steveyme19/barbell-tracker/hardware/enclosure/stl/puck_a.stl

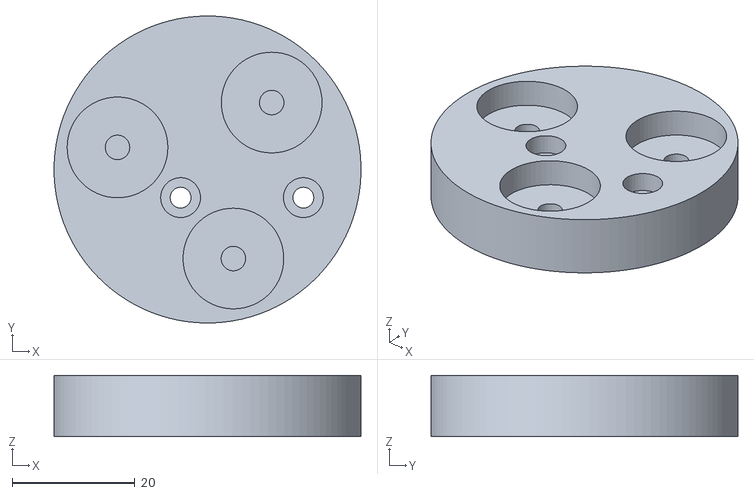
[picture p3: CAD file, 2026-10-30]
hardware/enclosure/stl/puck_a.stl
50.0 x 50.0 x 10.0
