steveyme19/barbell-tracker/hardware/enclosure/stl/pod_lid.stl

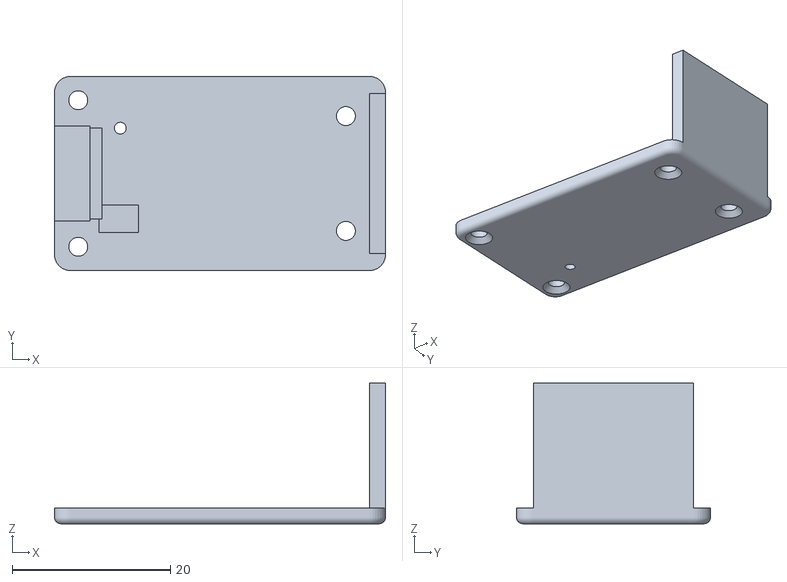
[picture p4: CAD file, 2026-10-30]
hardware/enclosure/stl/pod_lid.stl
41.8 x 24.5 x 17.8
