steveyme19/barbell-tracker/hardware/enclosure/stl/pod_case.stl

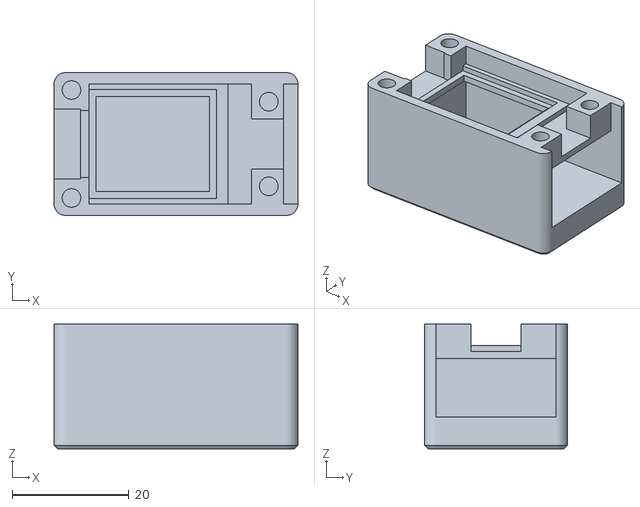
[picture p5: CAD file, 2026-10-30]
hardware/enclosure/stl/pod_case.stl
41.8 x 24.5 x 21.4
