steveyme19/barbell-tracker/analysis/make_fake_motion.py

"""
Fake IMU recordings with known truth for orientation and bar path (roadmap 0.3, algorithm.md
sections 2, 11, 12; checked by orientation.py --selftest).

    python make_fake_motion.py            # every scenario -> data/fake_motion_<name>.csv (+ _truth.csv)
    python make_fake_motion.py roll       # just one

Exact physics, then sensor noise: the device moves along min-jerk translations and turns about
one body axis at a time (which makes the gyro's body rate exact: theta_dot times that axis). The
accelerometer reads the specific force in the sensor frame, R^T (a + g up); the gyro reads the body
rate plus a constant bias and white noise. The mount is skewed on purpose (rolled 25 degrees about
the bar), so no sensor axis points up. World frame: x forward, y along the bar, z up. Sensor x
lies along the bar (a mount that forces it, algorithm.md section 11); every scenario starts with
the 2 s roll gesture anyway, so the bar axis can also be found from the gyro.

Scenarios (the roadmap 0.3 tests, plus a bench-style J-curve):
    flat      three 40 cm lifts, the device's attitude fixed
    tilt      the same lifts, the bar tilting 25 degrees (one end up) and back during each
    roll      the same lifts, the device rolling a full turn around the bar during each (sleeve spin)
    slide     slid 50 cm forward along a table and back, flat
    diagonal  lifted 30 cm up and 20 cm forward onto a table, and back down
    jcurve    three bench reps: 40 cm up with a 10 cm forward sweep, and back
    tiltroll  the bar tilted 20 degrees, two lifts spinning a full turn about the tilted bar, leveled
    early     the roll gesture before the first still (ending 10 degrees off where it began), then lifts

Gym scenarios (GYM, not in SCENARIOS: orientation.py --selftest runs every SCENARIOS entry against
the mount, noise and roll gesture above, and a loaded bar has none of those):
    squat_tng a whole touch-and-go squat set as the pod on Adapter A sees it (the 10-31 gym day):
              racked, unrack, walkout, 6 reps (one with a 0.85 s lockout pause), walk-in, a clanging
              rerack, racked. Writes data/fake_motion_squat_tng.csv, its per-sample _truth.csv and
              _truth.json with every rep's concentric start/end, ROM and MCV from the exact path
    deadlift_pins  10 dead-stop deadlifts from the pins (a rack pull), Adapter A: between reps the bar
              sits on the pins with hands on it (the 10-31 floor rests' 20 Hz: no still from the grip to
              the let-go) and every set-down leaves the sleeve spinning on its bearing, 2.5 turns in all.
              The gyro reads 1.5% fast, so without the quasi-still pulls (or with BAR_AXIS wrong) the
              attitude drifts 10 deg and the set falls apart; with them it holds. Same three files
    deadlift_creep  6 deadlifts from the floor, Adapter A, the accel calibrated: four leave the floor
              creeping (1 to 2.6 cm at 3.5 to 5.5 cm/s on average, |a| under 0.5: the 0.37 s flat test
              runs on into the pull), two with a 6 cm hitch (0.3 s at 2 to 3 cm/s, then the pull: 10-31's
              rep 1). Rep 1 comes out of a 5.5 s quiet setup (a true still: the window starts at the pull),
              the others after 1.5 s on the floor with hands on the bar and the set-down ringing. Same three files
"""

import sys
from pathlib import Path

import numpy as np

FS = 208.0                       # Hz, the pod's IMU rate (INFO odr)
G = 9.80665                      # m/s^2
ACC_NOISE = 0.012                # m/s^2, white (the pod's rest wiggle is ~0.01)
GYRO_NOISE = 0.07                # deg/s, white
GYRO_BIAS = np.array([0.4, -0.3, 0.2])   # deg/s, constant: orientation.py takes it from the stills
MOUNT_ROLL = 25.0                # deg: the device sits rolled about the bar, no axis points up
HEADER = ('"Time (s)","Acceleration x (m/s^2)","Acceleration y (m/s^2)","Acceleration z (m/s^2)",'
          '"Absolute acceleration (m/s^2)","Gyro x (deg/s)","Gyro y (deg/s)","Gyro z (deg/s)"')
OUT = Path(__file__).parent / "data"


def min_jerk(tau):
    """s, ds/dtau, d2s/dtau2 of the min-jerk profile 10t^3 - 15t^4 + 6t^5 on [0, 1]."""
    return (10 * tau**3 - 15 * tau**4 + 6 * tau**5, 30 * tau**2 - 60 * tau**3 + 30 * tau**4,
            60 * tau - 180 * tau**2 + 120 * tau**3)


def rot(axis, angle):
    """Rotation matrix about a unit axis (Rodrigues)."""
    a = np.asarray(axis, float) / np.linalg.norm(axis)
    k = np.array([[0, -a[2], a[1]], [a[2], 0, -a[0]], [-a[1], a[0], 0]])
    return np.eye(3) + np.sin(angle) * k + (1 - np.cos(angle)) * k @ k


# the mount: sensor x along the bar (world y), sensor y backward, z up, then rolled about the bar
R_MOUNT = rot([0, 1, 0], np.radians(MOUNT_ROLL)) @ np.array([[0, -1, 0], [1, 0, 0], [0, 0, 1]], float)


def build(segments, fs=FS, seed=1):
    """segments: ("still", T) | ("move", T, dp_world, body_axis or None, dtheta_deg).
    A move translates by dp (min-jerk) and turns about a fixed body axis by dtheta (min-jerk), at
    once. Returns t, accel (sensor, with g), gyro (deg/s, sensor), and the truth: position (world),
    the rotation sensor -> world per sample."""
    rng = np.random.default_rng(seed)
    total = sum(s[1] for s in segments)
    n = int(round(total * fs)) + 1
    t = np.arange(n) / fs
    pos, acc_w = np.zeros((n, 3)), np.zeros((n, 3))
    R = np.zeros((n, 3, 3))
    w_b = np.zeros((n, 3))
    p0, R0, t0 = np.zeros(3), R_MOUNT.copy(), 0.0
    for seg in segments:
        T = seg[1]
        m = (t >= t0 - 1e-9) & (t < t0 + T - 1e-9) if seg is not segments[-1] else (t >= t0 - 1e-9)
        tau = np.clip((t[m] - t0) / T, 0, 1)
        if seg[0] == "still":
            pos[m], R[m] = p0, R0
        else:
            _, _, dp, axis, dth = seg
            s, ds, dds = min_jerk(tau)
            dp = np.asarray(dp, float)
            pos[m] = p0 + np.outer(s, dp)
            acc_w[m] = np.outer(dds / T**2, dp)
            if axis is not None and dth:
                th = np.radians(dth) * s
                R[m] = np.array([R0 @ rot(axis, a) for a in th])
                w_b[m] = np.outer(np.radians(dth) * ds / T, np.asarray(axis, float) / np.linalg.norm(axis))
            else:
                R[m] = R0
            p0 = p0 + dp
            if axis is not None and dth:
                R0 = R0 @ rot(axis, np.radians(dth))
        t0 += T
    f_w = acc_w + np.array([0, 0, G])                       # specific force, world
    acc = np.einsum("nji,nj->ni", R, f_w)                  # R^T f: into the sensor frame
    acc += rng.normal(0, ACC_NOISE, acc.shape)
    gyro = np.degrees(w_b) + GYRO_BIAS + rng.normal(0, GYRO_NOISE, w_b.shape)
    return t, acc, gyro, {"pos": pos, "R": R}


BAR = [1, 0, 0]                  # the bar axis, sensor frame (the mount puts sensor x along it)
FWD_BODY = R_MOUNT.T @ np.array([1.0, 0, 0])   # world forward, seen from the mounted sensor


def roll_gesture():
    """Rolling the bar back and forth in the hooks, ~2 s (algorithm.md section 11)."""
    return [("move", 0.5, [0, 0, 0], BAR, 40), ("move", 0.7, [0, 0, 0], BAR, -80), ("move", 0.5, [0, 0, 0], BAR, 40)]


def lifts(n, up, fwd=0.0, axis=None, dth=0.0, t_up=1.2, t_down=1.4, pause=1.5):
    seg = []
    for _ in range(n):
        seg += [("move", t_up, [fwd, 0, up], axis, dth), ("still", pause),
                ("move", t_down, [-fwd, 0, -up], axis, -dth if axis is not None and dth not in (360, -360) else dth),
                ("still", pause)]
    return seg


SCENARIOS = {
    "flat": lambda: [("still", 2.0)] + roll_gesture() + [("still", 1.5)] + lifts(3, 0.40),
    "tilt": lambda: [("still", 2.0)] + roll_gesture() + [("still", 1.5)] + lifts(3, 0.40, axis=FWD_BODY, dth=25),
    "roll": lambda: [("still", 2.0)] + roll_gesture() + [("still", 1.5)] + lifts(3, 0.40, axis=BAR, dth=360),
    "slide": lambda: [("still", 2.0)] + roll_gesture() + [("still", 1.5), ("move", 1.6, [0.5, 0, 0], None, 0),
                                                           ("still", 1.5), ("move", 1.6, [-0.5, 0, 0], None, 0), ("still", 1.5)],
    "diagonal": lambda: [("still", 2.0)] + roll_gesture() + [("still", 1.5), ("move", 1.5, [0.2, 0, 0.3], None, 0),
                                                              ("still", 1.5), ("move", 1.5, [-0.2, 0, -0.3], None, 0), ("still", 1.5)],
    "jcurve": lambda: [("still", 2.0)] + roll_gesture() + [("still", 1.5)] + lifts(3, 0.40, fwd=0.10, t_up=1.0, t_down=1.3, pause=1.0),
    # two body axes composed: the bar tilted 20 degrees, then spun a full turn about itself (the tilted
    # bar) during each lift, then leveled. A body/world mix-up in the gyro update shows here, not above
    "tiltroll": lambda: [("still", 2.0)] + roll_gesture() + [("still", 1.5), ("move", 0.6, [0, 0, 0], FWD_BODY, 20), ("still", 1.2)]
    + lifts(2, 0.40, axis=BAR, dth=360) + [("move", 0.6, [0, 0, 0], FWD_BODY, -20), ("still", 1.5)],
    # moving from the first sample: the bar rolled right after Start (a net 10 degrees), then still
    "early": lambda: [("move", 0.5, [0, 0, 0], BAR, 40), ("move", 0.7, [0, 0, 0], BAR, -80), ("move", 0.5, [0, 0, 0], BAR, 50),
                      ("still", 2.0)] + lifts(3, 0.40, pause=1.0),
}


def scenario(name, seed=1):
    return build(SCENARIOS[name](), seed=seed)


def write(name, seed=1):
    t, acc, gyro, truth = scenario(name, seed)
    OUT.mkdir(exist_ok=True)
    a = np.linalg.norm(acc, axis=1)
    rows = np.column_stack([t, acc, a, gyro])
    np.savetxt(OUT / f"fake_motion_{name}.csv", rows, delimiter=",", header=HEADER, comments="", fmt="%.6f")
    up = truth["R"][:, 2, :]                                # world up in the sensor frame, per sample
    bar_w = truth["R"] @ np.array(BAR, float)
    tilt = np.degrees(np.arcsin(np.clip(bar_w[:, 2], -1, 1)))
    np.savetxt(OUT / f"fake_motion_{name}_truth.csv", np.column_stack([t, truth["pos"], up, tilt]), delimiter=",",
               header="t,x_fwd,y_bar,z_up,up_sx,up_sy,up_sz,tilt_deg", comments="", fmt="%.6f")
    return OUT / f"fake_motion_{name}.csv"


# ---- Gym scenarios: a loaded bar, the pod on its sleeve end (Adapter A) ----
# Exact physics again, but a touch-and-go rep never stops: its turnarounds have v = 0 for an
# instant and a big acceleration (the bounce). So paths are quintics through knots (t, p, v, a),
# continuous up to the acceleration, and every motion is a sum of "tracks": (value, rate, rate of
# the rate) arrays with exact derivatives. The pod's mount: sensor x up (at roll 0), y forward, z
# along the bar, so gravity lies in the x-y plane and the sleeve's roll turns it about z.

R_POD = np.array([[0, 1, 0], [0, 0, 1], [1, 0, 0]], float)   # columns: sensor x, y, z in the world (up, fwd, bar)
BAR_POD = [0, 0, 1]                                # the bar axis, pod sensor frame
POD_ACC_NOISE = np.array([0.02, 0.02, 0.007])      # m/s^2 per axis: a racked bar's rest wiggle (10-31 gym)
POD_GYRO_NOISE = 0.05                              # deg/s (same)
POD_GYRO_BIAS = np.array([0.74, -3.36, 2.18])      # deg/s: the pod's own, from the 10-31 racked stills
POD_ACC_OFFSET = np.array([-0.18, -0.055, 0.0])    # m/s^2: uncalibrated (calib_pod.py, D37, not applied yet)
POD_ACC_SCALE = 9.849 / G                          # so |a| at rest is the day-1 fit: 9.849 - 0.179 cos(roll) - 0.055 sin(roll)
POD_ACC_LSB, POD_ACC_MAX = 0.002393, 8 * G         # m/s^2: the LSM6DS3 at +-8 g (the recordings' step)
POD_GYRO_LSB, POD_GYRO_MAX = 0.035, 1000.0         # deg/s: ... at +-1000 deg/s
SWAY_HZ = 2.7                                      # standing under the bar isn't still (10-31: ~2.7 Hz)
RING_TAU, RING_ONSET = 0.25, 0.008                 # s: a clang's ringing decays (e-fold), and how fast it starts:
                                                   # under 2 samples, but not under one (a 3 ms onset left 49 mm/s
                                                   # in the integrated accel after the knock, 8 ms leaves ~1)


def track(n):
    return np.zeros(n), np.zeros(n), np.zeros(n)


def add(*tracks):
    return tuple(sum(k[i] for k in tracks) for i in range(3))


def mul(f, g):
    """The product of two tracks, with its derivatives (the product rule, twice)."""
    return f[0] * g[0], f[1] * g[0] + f[0] * g[1], f[2] * g[0] + 2 * f[1] * g[1] + f[0] * g[2]


def quintic(t, t0, t1, start, end):
    """The quintic through (p, v, a) at t0 and at t1, evaluated on t: a track."""
    T = t1 - t0
    (p0, v0, a0), (p1, v1, a1) = start, end
    # p(tau) = sum c_k tau^k, tau = (t - t0) / T: rows are p, p', p'' at tau = 0, then at tau = 1
    M = np.array([[1, 0, 0, 0, 0, 0], [0, 1, 0, 0, 0, 0], [0, 0, 2, 0, 0, 0],
                  [1, 1, 1, 1, 1, 1], [0, 1, 2, 3, 4, 5], [0, 0, 2, 6, 12, 20]], float)
    c = np.linalg.solve(M, [p0, v0 * T, a0 * T**2, p1, v1 * T, a1 * T**2])
    tau = (t - t0) / T
    k = np.arange(6)
    return (np.polyval(c[::-1], tau), np.polyval((c * k)[1:][::-1], tau) / T,
            np.polyval((c * k * (k - 1))[2:][::-1], tau) / T**2)


def through(t, knots):
    """A path through knots [(t, p, v, a)]: a quintic between each pair, held at the first knot's p
    before it and the last's after it (so the end knots need v = a = 0, or something else after)."""
    p, v, a = track(len(t))
    p[:] = knots[0][1]
    for k0, k1 in zip(knots[:-1], knots[1:]):
        m = (t >= k0[0]) & (t < k1[0])
        p[m], v[m], a[m] = quintic(t[m], k0[0], k1[0], k0[1:], k1[1:])
    p[t >= knots[-1][0]] = knots[-1][1]
    return p, v, a


def steps(t, moves):
    """Sum of min-jerk steps [(t0, T, delta)]: a track."""
    out = track(len(t))
    for t0, T, d in moves:
        s, ds, dds = min_jerk(np.clip((t - t0) / T, 0, 1))
        inside = (t > t0) & (t < t0 + T)
        out = add(out, (d * s, d * ds / T * inside, d * dds / T**2 * inside))
    return out


def sine(t, t0, amp, hz, phase=0.0):
    w = 2 * np.pi * hz
    x = w * (t - t0) + phase
    return amp * np.sin(x), amp * w * np.cos(x), -amp * w * w * np.sin(x)


def sway(t, t0, t1, amp, hz=SWAY_HZ, ramp=0.25, phase=np.pi):
    """amp * sin at hz from t0 to t1, faded in and out over `ramp` s (min-jerk), so it starts and
    stops with no jump. phase pi: it starts downward (a soft stop's top stays the top)."""
    s0, d0, dd0 = min_jerk(np.clip((t - t0) / ramp, 0, 1))
    s1, d1, dd1 = min_jerk(np.clip((t - (t1 - ramp)) / ramp, 0, 1))
    on = (t > t0) & (t < t1)
    env = ((s0 - s1) * on, (d0 - d1) / ramp * on, (dd0 - dd1) / ramp**2 * on)
    return mul(env, sine(t, t0, amp, hz, phase))


def ring(t, t0, amp, hz):
    """A clang's ringing from t0: amp e^(-s/RING_TAU) (1 - e^(-s/RING_ONSET))^3 sin(2 pi hz s), s = t - t0.
    The cubed onset starts it with no jump in the acceleration or its rate (a jerk that jumps at t0
    leaves velocity in the sampled accel: 14 mm/s from the knock with a squared onset); no net motion."""
    s = np.maximum(t - t0, 0)
    e, o = np.exp(-s / RING_TAU), np.exp(-s / RING_ONSET)
    decay = (e, -e / RING_TAU, e / RING_TAU**2)
    onset = (1 - o, o / RING_ONSET, -o / RING_ONSET**2)
    env = mul(decay, mul(onset, mul(onset, onset)))
    return tuple(k * (t >= t0) for k in mul(env, sine(t, t0, amp, hz)))


def landing(t, t_hit, v_hit, T):
    """Height above the hooks from t_hit on: the bar comes down at v_hit (< 0) and a sin^2 pulse of
    upward acceleration (peak -2 v_hit / T) stops it in T s, -v_hit T / 2 lower. 0 after that."""
    p, v, a = track(len(t))
    s = t - t_hit
    m = (s >= 0) & (s < T)
    A = -2 * v_hit / T
    sm = s[m]
    p[m] = -v_hit * T / 2 + v_hit * sm + A * (sm**2 / 4 + T**2 / (8 * np.pi**2) * (np.cos(2 * np.pi * sm / T) - 1))
    v[m] = v_hit + A * (sm / 2 - T / (4 * np.pi) * np.sin(2 * np.pi * sm / T))
    a[m] = A * np.sin(np.pi * sm / T) ** 2
    return p, v, a


def of_depth(z, z_top, c1, c2):
    """c1 u + c2 u^2 with u = z_top - z (how far below standing): a track that follows the rep."""
    u = (z_top - z[0], -z[1], -z[2])
    return (c1 * u[0] + c2 * u[0]**2, (c1 + 2 * c2 * u[0]) * u[1], 2 * c2 * u[1]**2 + (c1 + 2 * c2 * u[0]) * u[2])


def rots(axis, angles):
    """Rotation matrices (n, 3, 3) about one fixed axis (rot(), for an array of angles)."""
    a = np.asarray(axis, float)
    k = np.array([[0, -a[2], a[1]], [a[2], 0, -a[0]], [-a[1], a[0], 0]])
    return np.eye(3) + np.sin(angles)[:, None, None] * k + (1 - np.cos(angles))[:, None, None] * (k @ k)


STAND = 0.11                     # m: standing height above the hooks (the unrack lifts the bar this much)
BOUNCE = 0.1                     # s: the bounce out of the bottom runs this long either side of it, at a
                                 # steady jerk, from a quarter of its peak acceleration to the peak and back
# one row per rep: eccentric s, concentric s, depth below standing m, top short of standing m, the
# bounce's peak acceleration m/s^2 (at the bottom), top acceleration m/s^2 (0 = a soft stop), lockout
# pause after it s. 10-31: touch-and-go tops 5 to 8 cm short of standing, 1.5 s (135 lb) to 3 s (360 lb)
# a rep, ROM 55 to 65 cm; |a| spiking to 17-22 at a 135 bottom and dipping to ~3 at its top, the 360
# swinging only 7.5 to 12; the 360 had one 0.85 s lockout pause
SQUAT_TNG_REPS = [
    (0.85, 0.70, 0.67, 0.06, 10.0, -6.5, 0.0),
    (0.75, 0.75, 0.68, 0.05, 11.0, -6.0, 0.0),
    (0.75, 0.85, 0.64, 0.01, 10.0, 0.0, 0.85),    # all the way up, then the pause
    (0.80, 0.95, 0.63, 0.07, 8.0, -4.0, 0.0),
    (0.75, 1.10, 0.65, 0.08, 6.0, -3.0, 0.0),
    (0.80, 1.60, 0.64, 0.00, 4.0, 0.0, 0.0),      # the grinder, all the way up
]
# squat_breath (D43): a heavy set breathed at lockout, a check that D43's lockout rules leave a squat as it was
# (10-31's squats have one 0.85 s pause). On the squat's 0.75 s high-pass neither rule decides anything here:
# the 6 cm/s ease-down reads 0.016 m/s on the coarse height and passes TA_HOLD_V, the 8 cm/s one leaves no flat
# run. The same columns, plus an eighth: (m/s, s) the top eases down out of a soft stop at that speed for that
# long, no stop, then the descent proper, or None
SQUAT_BREATH_REPS = [
    (0.85, 0.85, 0.65, 0.00, 9.0, 0.0, 2.5, None),            # all the way up, a 2.5 s breath
    (0.80, 0.90, 0.64, 0.00, 9.0, 0.0, 0.0, (0.08, 0.40)),    # eases down out of lockout at 8 cm/s
    (0.80, 1.00, 0.65, 0.00, 8.0, 0.0, 3.0, None),            # a 3 s breath
    (0.85, 1.15, 0.64, 0.00, 7.0, 0.0, 0.0, (0.06, 0.45)),
    (0.85, 1.40, 0.63, 0.00, 5.0, 0.0, 0.0, None),            # the grinder, all the way up
]


def squat_tng(seed=1, fs=FS, rows=SQUAT_TNG_REPS):
    """The set, start to end: t, accel, gyro (as the pod writes them) and the truth: position,
    velocity, the rotation sensor -> world per sample, the reps and when everything happens.
    rows: SQUAT_TNG_REPS, or SQUAT_BREATH_REPS (squat_breath)."""
    rng = np.random.default_rng(seed)
    ev = dict(racked=(0.0, 2.0), unrack=(2.0, 2.9), walkout=(2.9, 4.5), stand_before=(4.5, 5.6))
    # the vertical: knots through the unrack, the walkout's 3 steps (each bobs 1.2 cm), the reps
    z_knots = [(0.0, 0.0, 0, 0), (2.0, 0.0, 0, 0), (2.9, STAND, 0, 0)]
    for k in range(3):
        t0 = 2.9 + k * 1.6 / 3
        z_knots += [(t0 + 0.8 / 3, STAND - 0.012, 0, 0), (t0 + 1.6 / 3, STAND, 0, 0)]
    t_now = 5.6
    z_knots.append((t_now, STAND, 0, 0))
    reps, pauses, drifts = [], [], []
    ecc = t_now                                    # where the next rep's descent starts
    for k, row in enumerate(rows):
        te, tc, depth, short, a_bot, a_top, pause = row[:7]
        drift = row[7] if len(row) > 7 else None
        t_bot, t_top = t_now + te, t_now + te + tc
        z_bot, z_top = STAND - depth, STAND - short
        # the bounce: a steady jerk from a_bot / 4 at t_bot - BOUNCE to a_bot at the bottom and back,
        # which fixes the speed and height at its edges (a quintic through them stays that cubic)
        a_edge = a_bot / 4
        v_edge, z_edge = BOUNCE * (a_edge + a_bot) / 2, z_bot + BOUNCE**2 * (2 * a_bot + a_edge) / 6
        z_knots += [(t_bot - BOUNCE, z_edge, -v_edge, a_edge), (t_bot, z_bot, 0, a_bot),
                    (t_bot + BOUNCE, z_edge, v_edge, a_edge), (t_top, z_top, 0, a_top)]
        reps.append(dict(rep=k + 1, t_start=t_bot, t_end=t_top, ecc_start=ecc, z_bottom=z_bot, z_top=z_top,
                         short_of_standing=short, pause_after=pause))
        if pause:
            assert a_top == 0, "a pause needs a soft stop at the top"
            z_knots.append((t_top + pause, z_top, 0, 0))
            pauses.append((t_top, t_top + pause))
        t_now = ecc = t_top + pause
        if drift:
            # eases down: up to -vd in tr s from the soft stop, then a steady -vd (it sways like a hold: a
            # smooth one would coast at a steady speed and pass the still test)
            assert a_top == 0 and not pause, "a drift eases down out of a soft stop"
            vd, td = drift
            tr = 0.15
            z1 = z_top - vd * tr / 2
            z_knots += [(t_top + tr, z1, -vd, 0), (t_top + td, z1 - vd * (td - tr), -vd, 0)]
            drifts.append((t_top, t_top + td))
            ecc, t_now = t_top, t_top + td
    assert rows[-1][5] == 0 and not (rows[-1][7:] and rows[-1][7]), "the set ends standing (a soft stop)"
    t_last = t_now
    ev.update(reps=(5.6, t_last), stand_after=(t_last, t_last + 1.1), walkin=(t_last + 1.1, t_last + 2.7),
              lean=(t_last + 2.7, t_last + 3.2), rerack=(t_last + 3.2, t_last + 3.8))
    if drifts:
        ev["drifts"] = drifts
    ev["knock"] = ev["walkin"][1] - 0.1            # the bar touches the uprights (10-31: 1.65 s before the hooks)
    # onto the hooks, then it rattles in them: 10-31's 135 rerack hit 4 times in 0.8 s (|a - g| peaks
    # 30, 30, 34, 49; the |a| it rectified added 6.8 m/s to the old integration, the knock 1.0)
    ev["clangs"] = tuple(ev["rerack"][1] + d for d in (0.0, 0.12, 0.42, 0.80))
    total = ev["clangs"][-1] + 3.5                 # the ringing (~1.5 s), then ~2 s racked
    n = int(round(total * fs)) + 1
    t = np.arange(n) / fs
    z_knots.append((ev["walkin"][0], STAND, 0, 0))
    w0, w1 = ev["walkin"]
    for k in range(3):
        t0 = w0 + k * (w1 - w0) / 3
        z_knots += [(t0 + (w1 - w0) / 6, STAND - 0.012, 0, 0), (t0 + (w1 - w0) / 3, STAND, 0, 0)]
    v_hit, t_stop = -0.30, 0.02                    # m/s onto the hooks, stopped in 20 ms
    z_knots += [(ev["rerack"][0], STAND, 0, 0), (ev["rerack"][1], -v_hit * t_stop / 2, v_hit, 0)]
    z = through(t, z_knots)
    after = t >= ev["rerack"][1]
    land = landing(t, ev["rerack"][1], v_hit, t_stop)
    z = tuple(np.where(after, land[i], z[i]) for i in range(3))

    # forward: 3 steps back (38 cm), the squat's bar path (5 cm forward at the bottom), 3 steps in
    o0, o1 = ev["walkout"]
    x = add(steps(t, [(o0 + k * (o1 - o0) / 3, (o1 - o0) / 3, -0.38 / 3) for k in range(3)]
                  + [(w0 + k * (w1 - w0) / 3, (w1 - w0) / 3, 0.38 / 3) for k in range(3)]),
            of_depth(z, STAND, 0.04, 0.05))
    # along the bar: the weight shifting side to side with each step
    y = steps(t, [(o0, 0.53, 0.012), (o0 + 0.53, 0.53, -0.02), (o0 + 1.07, 0.53, 0.011), (w0, 0.53, -0.013),
                  (w0 + 0.53, 0.53, 0.021), (w0 + 1.07, 0.53, -0.011)])
    # standing sway: up and down 2 mm (|a| std ~0.4 m/s^2), fore and aft 3 mm, lighter while leaning in
    stands = [ev["stand_before"], ev["stand_after"]] + pauses + drifts
    sway_z = add(*[sway(t, a, b, 0.002) for a, b in stands], sway(t, *ev["lean"], 0.0007))
    sway_x = add(*[sway(t, a, b, 0.003, phase=0.0) for a, b in stands], sway(t, *ev["lean"], 0.001, phase=0.0))
    # the clangs ring: up/down, fore/aft and along the bar (displacement = acceleration amplitude / w^2)
    bursts = [(ev["knock"], 0.7)] + list(zip(ev["clangs"], (1.0, 0.9, 1.0, 1.4)))   # (when, how hard)
    w2 = lambda hz: (2 * np.pi * hz) ** 2
    ring_z = add(*[ring(t, tb, s * 22 / w2(23), 23) for tb, s in bursts])
    ring_x = add(*[ring(t, tb, s * 18 / w2(26), 26) for tb, s in bursts])
    ring_y = add(*[ring(t, tb, s * 6 / w2(41), 41) for tb, s in bursts])
    pos = [add(x, sway_x, ring_x), add(y, ring_y), add(z, sway_z, ring_z)]

    # attitude, in degrees. Roll about the bar: up to ~35 deg through the set (10-31: 5 -> -8 -> 31 -> 14
    # -> 30 -> 39), plus 8 deg per m of depth. Tilt (one end up) and yaw (about vertical): a few degrees
    # with the steps and the depth, the sway's wobble, and the clangs (yaw rings hardest, like gyro x on 10-31).
    # The slow roll and yaw steps are timed to SQUAT_TNG_REPS as it stands (reps 5.6 to 17.1 s, the pause at 10.25);
    # squat_breath keeps them (they fall inside its longer set too)
    deg_per = lambda hz: 1 / (2 * np.pi * hz)      # angle amplitude per deg/s of ringing rate
    roll = add(steps(t, [(2.0, 2.2, -11), (4.4, 1.2, 4), (5.6, 4.6, 26), (10.5, 4.0, -10), (15.0, 3.0, 14),
                         (w0, w1 - w0, 2), (ev["rerack"][0], 0.6, 6)]),
               of_depth(z, STAND, 8.0, 0.0), add(*[ring(t, tb, s * 50 * deg_per(29), 29) for tb, s in bursts]))
    roll = (roll[0] + 5.0, roll[1], roll[2])       # racked at 5 deg
    tilt = add(steps(t, [(o0, 0.53, 0.6), (o0 + 0.53, 0.53, -1.0), (o0 + 1.07, 0.53, 0.4), (w0, 0.53, -0.5),
                         (w0 + 0.53, 0.53, 0.8), (w0 + 1.07, 0.53, -0.3)]),
               of_depth(z, STAND, 2.5, 0.0), *[sway(t, a, b, 0.12, phase=0.5) for a, b in stands],
               *[ring(t, tb, s * 110 * deg_per(37), 37) for tb, s in bursts])
    yaw = add(steps(t, [(o0, 0.53, 1.5), (o0 + 0.53, 0.53, -2.5), (o0 + 1.07, 0.53, 1.0), (5.6, 4.6, 0.8),
                        (10.5, 6.6, -0.8), (w0, 0.53, -1.2), (w0 + 0.53, 0.53, 2.0), (w0 + 1.07, 0.53, -0.8)]),
              *[sway(t, a, b, 0.10, phase=2.0) for a, b in stands],
              *[ring(t, tb, s * 260 * deg_per(31), 31) for tb, s in bursts])
    # R = Rz_world(yaw) Rx_world(tilt) R_POD Rz_sensor(phi), phi = -roll, so up in the sensor frame is
    # (cos roll, sin roll, 0). Body rate, exact: Rphi^T R_POD^T (Rtilt^T yaw' Z + tilt' X) + phi' z
    phi, phi_rate = -np.radians(roll[0]), -np.radians(roll[1])
    Ry, Rt, Rp = rots([0, 0, 1], np.radians(yaw[0])), rots([1, 0, 0], np.radians(tilt[0])), rots([0, 0, 1], phi)
    R = Ry @ Rt @ R_POD @ Rp
    w_world = np.einsum("nji,j->ni", Rt, [0, 0, 1.0]) * np.radians(yaw[1])[:, None] + np.outer(np.radians(tilt[1]), [1, 0, 0])
    w_b = np.einsum("nji,nj->ni", Rp, w_world @ R_POD) + np.outer(phi_rate, [0, 0, 1])

    acc_w = np.column_stack([p[2] for p in pos])
    f_s = np.einsum("nji,nj->ni", R, acc_w + np.array([0, 0, G]))       # R^T (a + g up)
    acc = POD_ACC_SCALE * f_s + POD_ACC_OFFSET + rng.normal(0, 1, f_s.shape) * POD_ACC_NOISE
    acc = np.clip(np.round(acc / POD_ACC_LSB) * POD_ACC_LSB, -POD_ACC_MAX, POD_ACC_MAX)
    gyro = np.degrees(w_b) + POD_GYRO_BIAS + rng.normal(0, POD_GYRO_NOISE, w_b.shape)
    gyro = np.clip(np.round(gyro / POD_GYRO_LSB) * POD_GYRO_LSB, -POD_GYRO_MAX, POD_GYRO_MAX)

    # the truth per rep, from the exact path: bottom to top turnaround (v = 0 at both), checked to go
    # up all the way (a knot change that makes a rep reverse mid-way fails here, not in a test)
    v_up = pos[2][1]
    for r in reps:
        tf = np.linspace(r["t_start"], r["t_end"], 4001)
        vf = through(tf, z_knots)[1]
        assert (vf[1:-1] > 0).all(), f"rep {r['rep']} doesn't go up all the way"
        te = np.linspace(r["ecc_start"], r["t_start"], 4001)
        assert (through(te, z_knots)[1][1:-1] < 0).all(), f"rep {r['rep']}'s descent doesn't go down all the way"
        r.update(rom=r["z_top"] - r["z_bottom"], dur=r["t_end"] - r["t_start"], peak_v=float(vf.max()),
                 t_peak=float(tf[np.argmax(vf)]))
        r["mcv"] = r["rom"] / r["dur"]
    pos_w = np.column_stack([p[0] for p in pos])
    return t, acc, gyro, {"pos": pos_w, "v_up": v_up, "R": R, "reps": reps, "events": ev}


# ---- deadlift_pins: what the quasi-stills are for (reps.quasi_stills, BAR_AXIS; D40's "weakly guarded") ----
# Between a deadlift's reps the bar never holds still (the 10-31 floor rests rang at 20 Hz, 0.5 to 2
# m/s^2 std, as long as hands were on the bar), so the attitude is pulled onto gravity only at the
# quasi-stills, and a sleeve spinning on its bearing passes those only because the turn about the bar
# is left out. On the pins (a rack pull) the plates hang free, so a set-down leaves the sleeve
# spinning (5 to 25 deg/s at rest, reps.QS_GYRO's note). Then a gyro scale error builds with every
# turn: 1.5% of 2.5 turns is 13 deg (10 by the last rep here, the stills' median taking a little of it
# back), and a vertical that far off breaks the anchors.
# The accel is the pod's own (offset, scale, noise, LSB) with its calibration taken back out, as the app
# applies it (D42): uncalibrated, its roll-dependent offset moves the vertical at rest by up to 0.37
# m/s^2 as the sleeve turns (the 10 deg move it 0.15), and on its own costs the current code this set's
# last rep (sets.py: 9 of 10, in every variant of this set tried). That's a test of its own; this one
# is the attitude
POD_GYRO_SCALE = 1.015           # the gyro's scale, uncalibrated (spec'd to a few %; D37 took 1.5% as its case)
PIN_REPS = [                     # concentric s, ROM m, lockout hold s, lowering s, rest on the pins after s:
    (0.70, 0.31, 0.3, 0.9, 1.8), # slowing from 0.44 to 0.24 m/s (10-31's deadlift: 0.50 to 0.55 from
    (0.75, 0.31, 0.3, 0.9, 1.8), # the floor, 53 cm); 1.0 s on the pins after the last, then hands off
    (0.81, 0.31, 0.3, 0.9, 1.8),
    (0.86, 0.30, 0.3, 0.9, 1.8),
    (0.92, 0.30, 0.3, 0.9, 1.8),
    (0.98, 0.30, 0.3, 0.9, 1.8),
    (1.03, 0.30, 0.3, 0.9, 1.8),
    (1.09, 0.29, 0.3, 0.9, 1.8),
    (1.14, 0.29, 0.3, 0.9, 1.8),
    (1.20, 0.29, 0.3, 0.9, 1.0),
]
PIN_HIT, PIN_STOP = -0.30, 0.02  # m/s onto the pins, stopped in 20 ms (peak 30 m/s^2: a jolt)
PIN_SPIN, PIN_DRAG = 25.0, 1.0   # deg/s: each set-down spins the sleeve up to this in 60 ms; deg/s^2: the
                                 # bearing's dry friction slows it (21 deg/s by the next set-down)
CONTACT_HZ, CONTACT_A = 20.5, 1.0   # the bar on its supports with hands on it: Hz, m/s^2 up (0.8 x fore-aft)


def deadlift_pins(seed=1, fs=FS):
    """The set: t, accel (calibrated, D42), gyro (+1.5%) and the truth, like squat_tng's. Heights are
    above the pins; a rep is liftoff (v = 0, at rest on the pins) to lockout (v = 0, a soft stop)."""
    rng = np.random.default_rng(seed)
    first = 8.0                                    # still till 3, a touch (3 to 3.6), still, grip at 6
    ev = dict(still=(0.0, 3.0), touch=(3.0, 3.6), grip=(6.0, first))
    z_knots = [(0.0, 0.0, 0, 0)]
    reps, holds, lands, t_now = [], [], [], first
    p_hit = -PIN_HIT * PIN_STOP / 2
    for k, (tc, rom, hold, te, rest) in enumerate(PIN_REPS):
        t_top = t_now + tc
        t_hit = t_top + hold + te
        # lowered at up to ~0.5 m/s and slowed into the pins: -0.45 m/s and +1.5 m/s^2 0.2 s before the
        # hit (accel falling to 0 at it, so the knot's height is the trapezoid's less a T^2/12 term)
        ta, va, aa = 0.2, -0.45, 1.5
        z_knots += [(t_now, 0.0, 0, 0), (t_top, rom, 0, 0), (t_top + hold, rom, 0, 0),
                    (t_hit - ta, p_hit - (va + PIN_HIT) / 2 * ta - aa * ta * ta / 12, va, aa),
                    (t_hit, p_hit, PIN_HIT, 0), (t_hit + PIN_STOP, 0.0, 0, 0)]
        reps.append(dict(rep=k + 1, t_start=t_now, t_end=t_top, ecc_start=t_top + hold, z_bottom=0.0, z_top=rom))
        holds.append((t_top, t_top + hold))
        lands.append(t_hit)
        t_now = t_hit + rest
    ev.update(reps=(first, lands[-1]), lands=tuple(lands), let_go=t_now)
    total = t_now + 3.5                            # on the pins, sleeve still spinning, hands off
    n = int(round(total * fs)) + 1
    t = np.arange(n) / fs
    z = through(t, z_knots)
    for th in lands:
        on = (t >= th) & (t < th + PIN_STOP)
        land = landing(t, th, PIN_HIT, PIN_STOP)
        z = tuple(np.where(on, land[i], z[i]) for i in range(3))
    # the bar comes 2.5 cm back toward the hips at the top; the sleeve turns back 12 deg as it rises (the
    # 10-31 deadlift: -14 to -44 deg/s up, +25 down), the bar tilts and yaws a degree
    lin = lambda c: (c * z[0], c * z[1], c * z[2])
    # the 20 Hz while the bar sits on its supports with hands on it (the touch, the grip, every rest
    # until the next liftoff, the last until the let-go), and a light sway at the lockout (no still there)
    contact = [ev["touch"], ev["grip"]] + [(th + PIN_STOP, r["t_start"]) for th, r in zip(lands, reps[1:])]
    contact.append((lands[-1] + PIN_STOP, t_now))
    w2 = lambda hz: (2 * np.pi * hz) ** 2
    vib_z = add(*[sway(t, a, b, CONTACT_A / w2(CONTACT_HZ), hz=CONTACT_HZ, ramp=0.15) for a, b in contact])
    vib_x = add(*[sway(t, a, b, 0.8 * CONTACT_A / w2(1.05 * CONTACT_HZ), hz=1.05 * CONTACT_HZ, ramp=0.15, phase=0.7)
                  for a, b in contact])
    sway_z = add(*[sway(t, a, b, 0.001, ramp=(b - a) / 2) for a, b in holds])
    sway_x = add(*[sway(t, a, b, 0.0015, ramp=(b - a) / 2, phase=0.0) for a, b in holds])
    # each set-down clangs like squat_tng's rerack (steel on steel)
    ring_z = add(*[ring(t, th, 22 / w2(23), 23) for th in lands])
    ring_x = add(*[ring(t, th, 18 / w2(26), 26) for th in lands])
    ring_y = add(*[ring(t, th, 6 / w2(41), 41) for th in lands])
    pos = [add(lin(-0.08), vib_x, sway_x, ring_x), ring_y, add(z, vib_z, sway_z, ring_z)]

    # the sleeve's spin about the bar (deg): kicked to PIN_SPIN at each set-down, then dry friction
    s_knots, ang, w = [(0.0, 0.0, 0.0, 0.0)], 0.0, 0.0
    for j, th in enumerate(lands):
        s_knots.append((th, ang, w, -PIN_DRAG if w > 0 else 0.0))
        ang += (w + PIN_SPIN) / 2 * 0.06
        s_knots.append((th + 0.06, ang, PIN_SPIN, -PIN_DRAG))
        T = (lands[j + 1] if j + 1 < len(lands) else total + 1.0) - (th + 0.06)
        w = max(PIN_SPIN - PIN_DRAG * T, 0.0)
        assert w > 0, "the sleeve stops between set-downs: give it a knot at rest"
        ang += (PIN_SPIN + w) / 2 * T
    s_knots.append((total + 1.0, ang, w, -PIN_DRAG))
    spin = through(t, s_knots)
    deg_per = lambda hz: 1 / (2 * np.pi * hz)
    roll = add(spin, lin(-40.0), *[ring(t, th, 50 * deg_per(29), 29) for th in lands])
    roll = (roll[0] + 5.0, roll[1], roll[2])       # on the pins at 5 deg
    tilt = add(lin(3.0), *[ring(t, th, 110 * deg_per(37), 37) for th in lands])
    yaw = add(lin(-2.0), *[ring(t, th, 260 * deg_per(31), 31) for th in lands])
    # the same composition as squat_tng: R = Rz(yaw) Rx(tilt) R_POD Rz(-roll), exact body rate
    phi, phi_rate = -np.radians(roll[0]), -np.radians(roll[1])
    Ry, Rt, Rp = rots([0, 0, 1], np.radians(yaw[0])), rots([1, 0, 0], np.radians(tilt[0])), rots([0, 0, 1], phi)
    R = Ry @ Rt @ R_POD @ Rp
    w_world = np.einsum("nji,j->ni", Rt, [0, 0, 1.0]) * np.radians(yaw[1])[:, None] + np.outer(np.radians(tilt[1]), [1, 0, 0])
    w_b = np.einsum("nji,nj->ni", Rp, w_world @ R_POD) + np.outer(phi_rate, [0, 0, 1])

    acc_w = np.column_stack([p[2] for p in pos])
    f_s = np.einsum("nji,nj->ni", R, acc_w + np.array([0, 0, G]))
    raw = POD_ACC_SCALE * f_s + POD_ACC_OFFSET + rng.normal(0, 1, f_s.shape) * POD_ACC_NOISE
    raw = np.clip(np.round(raw / POD_ACC_LSB) * POD_ACC_LSB, -POD_ACC_MAX, POD_ACC_MAX)
    acc = (raw - POD_ACC_OFFSET) / POD_ACC_SCALE   # the app's correction, (raw - bias) / scale (D42)
    gyro = POD_GYRO_SCALE * np.degrees(w_b) + POD_GYRO_BIAS + rng.normal(0, POD_GYRO_NOISE, w_b.shape)
    gyro = np.clip(np.round(gyro / POD_GYRO_LSB) * POD_GYRO_LSB, -POD_GYRO_MAX, POD_GYRO_MAX)

    for r in reps:                                 # up all the way, down all the way (as squat_tng)
        tf = np.linspace(r["t_start"], r["t_end"], 4001)
        vf = through(tf, z_knots)[1]
        assert (vf[1:-1] > 0).all(), f"rep {r['rep']} doesn't go up all the way"
        td = np.linspace(r["ecc_start"], ev["lands"][r["rep"] - 1], 4001)
        assert (through(td, z_knots)[1][1:-1] < 0).all(), f"rep {r['rep']}'s lowering doesn't go down all the way"
        r.update(rom=r["z_top"] - r["z_bottom"], dur=r["t_end"] - r["t_start"], peak_v=float(vf.max()),
                 t_peak=float(tf[np.argmax(vf)]))
        r["mcv"] = r["rom"] / r["dur"]
    pos_w = np.column_stack([p[0] for p in pos])
    sensor = dict(acc="the pod's raw accel (offset and scale below, noise, LSB) with its calibration taken back out (D42)",
                  acc_offset=POD_ACC_OFFSET.tolist(), acc_scale=POD_ACC_SCALE, acc_noise=POD_ACC_NOISE.tolist(),
                  gyro_bias=POD_GYRO_BIAS.tolist(), gyro_scale=POD_GYRO_SCALE, gyro_noise=POD_GYRO_NOISE,
                  acc_lsb=POD_ACC_LSB, gyro_lsb=POD_GYRO_LSB)
    return t, acc, gyro, {"pos": pos_w, "v_up": pos[2][1], "R": R, "reps": reps, "events": ev, "lift": "deadlift",
                          "note": "exact path: a rep is its liftoff from the pins to its lockout (v = 0 at both, continuous "
                                  "time); i_start/i_end are the nearest samples. Heights are above the pins; rom = z_top, "
                                  "mcv = rom / dur",
                          "extra": dict(spin_deg=float(spin[0][-1]), spin_kick=PIN_SPIN, spin_drag=PIN_DRAG),
                          "sensor": sensor}


# ---- deadlift_creep: how a floor pull breaks (reps.find_pause on the floor, TA_FLAT_WIN, TA_FLOOR_REACH) ----
# A deadlift doesn't always leave the floor at once. It can creep: the sleeve rises 1 to 2.6 cm over 0.27
# to 0.48 s at a nearly steady few cm/s with |a| under 0.5 m/s^2, so TA_FLAT_WIN's 0.37 s average reads it
# flat and the floor's flat run goes on into the pull (a review's case: the anchor then averages a bar
# that's already moving). Or it can hitch: a fast 6 cm rise, ~0.3 s under 0.05 m/s, then the pull (10-31's
# rep 1, +31% from the hitch until TA_FLOOR_REACH). Rep 1 comes out of a quiet 5.5 s setup, long and still
# enough for the still test, so the window starts at the pull itself (inside the creep); every other rep
# after 1.5 s on the floor with hands on the bar (CONTACT_HZ) and the set-down's clang ringing. The truth:
# a rep is liftoff (v = 0, on the floor) to lockout (v = 0), the creep or the hitch included.
# The accel is calibrated as in deadlift_pins (the pod's offset and scale put in, then taken back out,
# D42). The gyro has the pod's bias and noise but no scale error: the plates sit on the floor, so the
# sleeve doesn't spin, and only the floor is under test here
FLOOR_HIT, FLOOR_STOP = -0.50, 0.015   # m/s onto the floor, stopped in 15 ms (peak 67 m/s^2: 10-31's landings 67 to 76)
DL_FLOOR_REPS = [                # how it leaves the floor, then the pull s and ROM m (10-31: ~1 s, 51 to 54 cm)
    (("creep", 0.016, 0.36), 0.88, 0.52),              # creep: rises m in s (rep 1: out of the 5.5 s still)
    (("hitch", 0.060, 0.32, 0.03, 0.30), 0.80, 0.53),  # hitch: rises m in s, then m/s for s
    (("creep", 0.010, 0.29), 0.90, 0.52),              # (0.27 s would peak at 0.54 m/s^2)
    (("creep", 0.026, 0.48), 0.95, 0.52),
    (("hitch", 0.060, 0.30, 0.02, 0.35), 0.85, 0.51),
    (("creep", 0.021, 0.42), 1.05, 0.52),
]
DL_HOLD, DL_LOWER, DL_REST = 0.3, 1.0, 1.5   # s: at lockout, lowering, on the floor before the next pull


SOFT_RING = 0.15                 # deadlift_soft: the gyro's ring at a soft set-down, x the clang's (D43)


def deadlift_creep(seed=1, fs=FS, soft=False):
    """The set: t, accel (calibrated, D42), gyro and the truth, like deadlift_pins'. Heights are above
    the bar at rest on the floor; a rep is liftoff (v = 0) to lockout (v = 0).
    soft (deadlift_soft, D43): every set-down but the last barely turns the bar, its gyro ring x SOFT_RING
    (about 40 deg/s, under IMPACT_W): still a jolt that lands it, but not an impact (the last one is, so
    the window is still redone). A floor lift must keep landing on every jolt, not only the impacts"""
    rng = np.random.default_rng(seed)
    first = 8.5                                    # still till 2, the grip (2 to 3), the quiet setup, rep 1
    ev = dict(still=(0.0, 2.0), grip=(2.0, 3.0), setup=(3.0, first))
    z_knots = [(0.0, 0.0, 0, 0)]
    reps, holds, lands, breaks, t_now = [], [], [], [], first
    p_hit = -FLOOR_HIT * FLOOR_STOP / 2
    for k, (brk, tm, rom) in enumerate(DL_FLOOR_REPS):
        z_knots.append((t_now, 0.0, 0, 0))         # liftoff
        if brk[0] == "creep":
            # the review's creep: it ends at its mean speed with a = 0 as the pull starts (v peaks at 1.5x
            # that 60% of the way, |a| at 3.94 rise / s^2). Low and smooth, so an anchor that averages it
            # takes the creep's speed for zero, and the rep's start lands where the pull begins
            _, d, tb = brk
            vb = d / tb
            z_knots.append((t_now + tb, d, vb, 0))
        else:
            _, d0, tr, vb, tp = brk
            tb, d = tr + tp, d0 + vb * tp
            z_knots += [(t_now + tr, d0, vb, 0), (t_now + tb, d, vb, 0)]
        t_top = t_now + tb + tm
        t_hit = t_top + DL_HOLD + DL_LOWER
        # lowered at up to ~0.8 m/s, slowing to FLOOR_HIT: -0.7 m/s and +2 m/s^2 0.2 s before (deadlift_pins' knot)
        ta, va, aa = 0.2, -0.7, 2.0
        z_knots += [(t_top, rom, 0, 0), (t_top + DL_HOLD, rom, 0, 0),
                    (t_hit - ta, p_hit - (va + FLOOR_HIT) / 2 * ta - aa * ta * ta / 12, va, aa),
                    (t_hit, p_hit, FLOOR_HIT, 0), (t_hit + FLOOR_STOP, 0.0, 0, 0)]
        reps.append(dict(rep=k + 1, t_start=t_now, t_end=t_top, ecc_start=t_top + DL_HOLD, z_bottom=0.0, z_top=rom))
        breaks.append(dict(rep=k + 1, kind=brk[0], rise=d, dur=tb, v=vb, t_pull=t_now + tb))
        holds.append((t_top, t_top + DL_HOLD))
        lands.append(t_hit)
        t_now = t_hit + (DL_REST if k + 1 < len(DL_FLOOR_REPS) else 1.0)   # 1 s after the last, then hands off
    ev.update(reps=(first, lands[-1]), lands=tuple(lands), let_go=t_now)
    total = t_now + 3.5                            # the bar on the floor, nobody touching it
    n = int(round(total * fs)) + 1
    t = np.arange(n) / fs
    z = through(t, z_knots)
    for th in lands:
        on = (t >= th) & (t < th + FLOOR_STOP)
        land = landing(t, th, FLOOR_HIT, FLOOR_STOP)
        z = tuple(np.where(on, land[i], z[i]) for i in range(3))
    lin = lambda c: (c * z[0], c * z[1], c * z[2])
    # the 20 Hz with hands on the bar and the plates on the floor: the grip, each rest from the set-down to
    # the next liftoff, the last till the let-go (not the quiet setup: that's the still). A light sway at lockout
    contact = [ev["grip"]] + [(th + FLOOR_STOP, r["t_start"]) for th, r in zip(lands, reps[1:])]
    contact.append((lands[-1] + FLOOR_STOP, t_now))
    w2 = lambda hz: (2 * np.pi * hz) ** 2
    vib_z = add(*[sway(t, a, b, CONTACT_A / w2(CONTACT_HZ), hz=CONTACT_HZ, ramp=0.15) for a, b in contact])
    vib_x = add(*[sway(t, a, b, 0.8 * CONTACT_A / w2(1.05 * CONTACT_HZ), hz=1.05 * CONTACT_HZ, ramp=0.15, phase=0.7)
                  for a, b in contact])
    sway_z = add(*[sway(t, a, b, 0.001, ramp=(b - a) / 2) for a, b in holds])
    sway_x = add(*[sway(t, a, b, 0.0015, ramp=(b - a) / 2, phase=0.0) for a, b in holds])
    # each set-down clangs like deadlift_pins' (its jolt and the gyro's ring make reps.impact_mask fire)
    ring_z = add(*[ring(t, th, 22 / w2(23), 23) for th in lands])
    ring_x = add(*[ring(t, th, 18 / w2(26), 26) for th in lands])
    ring_y = add(*[ring(t, th, 6 / w2(41), 41) for th in lands])
    pos = [add(lin(-0.08), vib_x, sway_x, ring_x), ring_y, add(z, vib_z, sway_z, ring_z)]

    # the sleeve turns back 21 deg as it rises (deadlift_pins' 40 deg/m), the bar tilts and yaws a degree,
    # the clangs ring; no spin (the plates are on the floor)
    deg_per = lambda hz: 1 / (2 * np.pi * hz)
    gr = [SOFT_RING if soft and j < len(lands) - 1 else 1.0 for j in range(len(lands))]   # the gyro's ring, per set-down
    roll = add(lin(-40.0), *[ring(t, th, g * 50 * deg_per(29), 29) for th, g in zip(lands, gr)])
    roll = (roll[0] + 5.0, roll[1], roll[2])       # on the floor at 5 deg
    tilt = add(lin(3.0), *[ring(t, th, g * 110 * deg_per(37), 37) for th, g in zip(lands, gr)])
    yaw = add(lin(-2.0), *[ring(t, th, g * 260 * deg_per(31), 31) for th, g in zip(lands, gr)])
    # the same composition as squat_tng: R = Rz(yaw) Rx(tilt) R_POD Rz(-roll), exact body rate
    phi, phi_rate = -np.radians(roll[0]), -np.radians(roll[1])
    Ry, Rt, Rp = rots([0, 0, 1], np.radians(yaw[0])), rots([1, 0, 0], np.radians(tilt[0])), rots([0, 0, 1], phi)
    R = Ry @ Rt @ R_POD @ Rp
    w_world = np.einsum("nji,j->ni", Rt, [0, 0, 1.0]) * np.radians(yaw[1])[:, None] + np.outer(np.radians(tilt[1]), [1, 0, 0])
    w_b = np.einsum("nji,nj->ni", Rp, w_world @ R_POD) + np.outer(phi_rate, [0, 0, 1])

    acc_w = np.column_stack([p[2] for p in pos])
    f_s = np.einsum("nji,nj->ni", R, acc_w + np.array([0, 0, G]))
    raw = POD_ACC_SCALE * f_s + POD_ACC_OFFSET + rng.normal(0, 1, f_s.shape) * POD_ACC_NOISE
    raw = np.clip(np.round(raw / POD_ACC_LSB) * POD_ACC_LSB, -POD_ACC_MAX, POD_ACC_MAX)
    acc = (raw - POD_ACC_OFFSET) / POD_ACC_SCALE   # the app's correction, (raw - bias) / scale (D42)
    gyro = np.degrees(w_b) + POD_GYRO_BIAS + rng.normal(0, POD_GYRO_NOISE, w_b.shape)
    gyro = np.clip(np.round(gyro / POD_GYRO_LSB) * POD_GYRO_LSB, -POD_GYRO_MAX, POD_GYRO_MAX)

    for r, b in zip(reps, breaks):                 # up all the way, down all the way (as deadlift_pins)
        tf = np.linspace(r["t_start"], r["t_end"], 4001)
        vf = through(tf, z_knots)[1]
        assert (vf[1:-1] > 0).all(), f"rep {r['rep']} doesn't go up all the way"
        td = np.linspace(r["ecc_start"], ev["lands"][r["rep"] - 1], 4001)
        assert (through(td, z_knots)[1][1:-1] < 0).all(), f"rep {r['rep']}'s lowering doesn't go down all the way"
        if b["kind"] == "creep":                   # what makes it a creep: the flat test can't see it
            tc = np.linspace(r["t_start"], b["t_pull"], 4001)
            assert np.abs(through(tc, z_knots)[2]).max() < 0.5, f"rep {r['rep']}'s creep isn't under 0.5 m/s^2"
        r.update(rom=r["z_top"] - r["z_bottom"], dur=r["t_end"] - r["t_start"], peak_v=float(vf.max()),
                 t_peak=float(tf[np.argmax(vf)]))
        r["mcv"] = r["rom"] / r["dur"]
    pos_w = np.column_stack([p[0] for p in pos])
    sensor = dict(acc="the pod's raw accel (offset and scale below, noise, LSB) with its calibration taken back out (D42)",
                  acc_offset=POD_ACC_OFFSET.tolist(), acc_scale=POD_ACC_SCALE, acc_noise=POD_ACC_NOISE.tolist(),
                  gyro_bias=POD_GYRO_BIAS.tolist(), gyro_scale=1.0, gyro_noise=POD_GYRO_NOISE,
                  acc_lsb=POD_ACC_LSB, gyro_lsb=POD_GYRO_LSB)
    return t, acc, gyro, {"pos": pos_w, "v_up": pos[2][1], "R": R, "reps": reps, "events": ev, "lift": "deadlift",
                          "note": "exact path: a rep is its liftoff from the floor to its lockout (v = 0 at both, "
                                  "continuous time), the creep or the hitch included (breaks: how each leaves the "
                                  "floor, t_pull where the pull proper starts); i_start/i_end are the nearest samples. "
                                  "Heights are above the floor rest; rom = z_top, mcv = rom / dur. The accel is "
                                  "calibrated (the pod's offset and scale taken back out, D42); the gyro has no scale error",
                          "extra": dict(breaks=breaks, floor_hit=FLOOR_HIT, floor_stop=FLOOR_STOP,
                                        **(dict(soft_ring=SOFT_RING, soft_lands=lands[:-1]) if soft else {})),
                          "sensor": sensor}


GYM = {"squat_tng": squat_tng, "deadlift_pins": deadlift_pins, "deadlift_creep": deadlift_creep,
       "squat_breath": lambda seed=1: squat_tng(seed, rows=SQUAT_BREATH_REPS),
       "deadlift_soft": lambda seed=1: deadlift_creep(seed, soft=True)}


def write_gym(name, seed=1):
    """data/fake_motion_<name>.csv (the pod's columns), _truth.csv per sample (the columns above plus
    v_up and the roll), and _truth.json: the reps and when everything happens."""
    import json
    t, acc, gyro, truth = GYM[name](seed)
    OUT.mkdir(exist_ok=True)
    rows = np.column_stack([t, acc, np.linalg.norm(acc, axis=1), gyro])
    np.savetxt(OUT / f"fake_motion_{name}.csv", rows, delimiter=",", header=HEADER, comments="", fmt="%.6f")
    up = truth["R"][:, 2, :]
    bar_w = truth["R"] @ np.array(BAR_POD, float)
    tilt = np.degrees(np.arcsin(np.clip(bar_w[:, 2], -1, 1)))
    roll = np.degrees(np.arctan2(up[:, 1], up[:, 0]))              # the sleeve's roll, as gravity shows it
    np.savetxt(OUT / f"fake_motion_{name}_truth.csv", np.column_stack([t, truth["pos"], up, tilt, truth["v_up"], roll]),
               delimiter=",", header="t,x_fwd,y_bar,z_up,up_sx,up_sy,up_sz,tilt_deg,v_up,roll_deg", comments="", fmt="%.6f")
    fs = 1 / (t[1] - t[0])
    # squat_tng's fields are the defaults; another scenario says its own lift, note, extras and sensor
    keys = [k for k in ("rep", "t_start", "t_end", "dur", "rom", "mcv", "peak_v", "t_peak", "short_of_standing",
                        "pause_after") if k in truth["reps"][0]]
    out = dict(scenario=name, lift=truth.get("lift", "squat"), fs=fs, seed=seed, samples=len(t),
               note=truth.get("note", "exact path: a rep is its bottom turnaround to its top one (v = 0 at both, continuous "
                                      "time); i_start/i_end are the nearest samples. Heights are above the hooks; rom = "
                                      "z_top - z_bottom, mcv = rom / dur"),
               reps=[dict({k: r[k] for k in keys}, i_start=int(round(r["t_start"] * fs)), i_end=int(round(r["t_end"] * fs)),
                          z_bottom=r["z_bottom"], z_top=r["z_top"]) for r in truth["reps"]],
               events=truth["events"], **truth.get("extra", dict(stand_height=STAND)),
               roll_deg_range=[float(roll.min()), float(roll.max())],
               sensor=truth.get("sensor") or dict(acc_offset=POD_ACC_OFFSET.tolist(), acc_scale=POD_ACC_SCALE,
                                                  acc_noise=POD_ACC_NOISE.tolist(), gyro_bias=POD_GYRO_BIAS.tolist(),
                                                  gyro_noise=POD_GYRO_NOISE, acc_lsb=POD_ACC_LSB, gyro_lsb=POD_GYRO_LSB))
    rnd = lambda o: round(o, 6) if isinstance(o, float) else [rnd(v) for v in o] if isinstance(o, (list, tuple)) else \
        {k: rnd(v) for k, v in o.items()} if isinstance(o, dict) else o
    (OUT / f"fake_motion_{name}_truth.json").write_text(json.dumps(rnd(out), indent=1))
    return OUT / f"fake_motion_{name}.csv", truth["reps"]


if __name__ == "__main__":
    for name in (sys.argv[1:] or list(SCENARIOS) + list(GYM)):
        if name in GYM:
            path, reps = write_gym(name)
            roms = " ".join(f"{r['rom'] * 100:.0f}" for r in reps)
            mcvs = " ".join(f"{r['mcv']:.2f}" for r in reps)
            print(f"wrote {path}: {len(reps)} reps, ROM {roms} cm, MCV {mcvs} m/s")
        else:
            print(f"wrote {write(name)}")
