steveyme19/barbell-tracker/analysis/podlink.py

"""
PodLink v1: the reference decoder for the pod's Bluetooth stream (decision P1).

Implements docs/ble.md rule for rule. The JS PodStream in webapp/sources.js is a line-for-line
port of PodStream below, and make_fake_pod.py checks both against the same test vectors.
Standard library only.

    from podlink import PodStream
    s = PodStream(on_sample)          # on_sample({t, ax, ay, az, gx, gy, gz})
    s.packet(crp_pkt, arrival_ms)     # every CRP packet the pod sends, in arrival order (D45)
    s.frame(raw_bytes, arrival_ms)    # or every frame of any type (captures from before D45)
    cmd = s.command()                 # bytes to write to the CTRL register (STREAM_LIVE / STREAM_FROM)

Since D45 the frames travel inside CRP (docs/ble.md 2, analysis/crp.py): crp_frame() takes a
frame out of a packet, and PodStream itself never sees CRP.

The frame builders (build_data, build_status, build_info, build_cal) are the pod's side, used by
the simulator in make_fake_pod.py.

    python podlink.py --replay-all        # every committed capture still decodes the same (P2)
    python podlink.py --write-manifest    # pin the captures the manifest doesn't have yet
"""

import math
import struct
from collections import deque

import crp

# ---- the pod's CRP registers (docs/ble.md 2.3) ----
REG_PROTO, REG_INFO, REG_STATUS, REG_CAL = 0x00010000, 0x00010001, 0x00010002, 0x00010003
REG_DATA, REG_CTRL, REG_PUSH = 0x00010004, 0x00010005, 0x00010006
REG_LINK_KIND, REG_LINK_MTU, REG_LINK_N_MAX = 0x00030001, 0x00030002, 0x00030003
REG_BENCH = 0x00040001                     # USB only
DEVICE_ID = 0x444F5042                     # the pod's HELLO device_id, "BPOD" (42 50 4F 44 on the wire)
FRAME_READS = (REG_INFO, REG_STATUS, REG_CAL)   # an OK RESPONSE to a READ of these carries a frame
FRAME_PUSHES = (REG_DATA, REG_STATUS)           # so does a push (WRITE txn 0) to these

# ---- frame constants (docs/ble.md 3 and 4) ----
T_DATA, T_STATUS, T_INFO, T_CAL = 0x01, 0x10, 0x20, 0x30
F_RESYNC, F_OVERFLOW, F_IMU_RESTART, F_FINAL = 0x01, 0x02, 0x04, 0x08
S_USB, S_CHARGING, S_BATT_LOW, S_STREAMING = 0x01, 0x02, 0x04, 0x08
S_GOING_TO_SLEEP, S_STREAM_STOPPED, S_MTU_TOO_SMALL, S_BOOT_MISMATCH = 0x10, 0x20, 0x40, 0x80
OP_STREAM_FROM, OP_STREAM_LIVE, OP_STOP, OP_SLEEP = 0x01, 0x02, 0x03, 0x10

ACCEL_LSB = 0.061 * 4 / 1000 * 9.80665     # m/s^2 per count at +-8 g (= 0.0023928226)
GYRO_LSB = 4.375 * 8 / 1000                # deg/s per count at +-1000 deg/s (= 0.035)
TICK_HZ = 32768
LIVE_BACK = 600                            # STREAM_LIVE lead-in for a fresh session (~2.8 s)
SLEEP_REASONS = {0: "none", 1: "idle", 2: "lid-down", 3: "low battery", 4: "command", 5: "IMU lost"}

DATA_HDR = struct.Struct("<BBHIIBB")       # type n pkt_seq first_idx t0_ticks flags cmd_seq
DATA_SMP = struct.Struct("<H6h")           # dt_ticks gx gy gz ax ay az
STATUS_FMT = struct.Struct("<BBHIIHHBBH")  # 20 B
INFO_FMT = struct.Struct("<BBHIIffHHBBHI")  # 32 B


def int32(x):
    """The u32 difference x as a signed 32-bit number (JS: x | 0)."""
    x &= 0xFFFFFFFF
    return x - 0x100000000 if x >= 0x80000000 else x


def crp_frame(pkt):
    """The PodLink frame a CRP packet carries, or None (docs/ble.md 7, Feeding the decoder):
    an OK RESPONSE to a READ of INFO, STATUS or CAL gives its value; a push (WRITE txn 0) to DATA
    or STATUS gives its value; anything else (HELLO, NOP, LOG, BUSY, the answer to a write, a
    client's WRITE, a short or unknown packet) gives None. Pure: nothing is counted here, so a
    malformed frame inside a good packet still reaches the decoder's own checks (`bad`)."""
    b = bytes(pkt)
    if len(b) >= 8 and b[0] == crp.RESPONSE and b[2] == crp.OK:      # 0C txn status ch reg:u32 value
        if struct.unpack_from("<I", b, 4)[0] in FRAME_READS:
            return b[8:]
        return None
    if len(b) >= 6 and b[0] == crp.WRITE and b[1] == 0:               # 04 00 reg:u32 value
        if struct.unpack_from("<I", b, 2)[0] in FRAME_PUSHES:
            return b[6:]
    return None
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
