steveyme19/barbell-tracker/(commit log)

2026-10-15 Plan, docs, and step 0.1 scripts
    [sets_log.csv]
2026-10-16 Phone lift recordings, read xlsx/zip exports, measure peak
    [lift_02.xlsx, lift_03.xlsx, lift_04.xlsx, lift_05.xlsx]
2026-10-16 Step 0.2: rep splitter, tilt-proof signal, rep recordings
    - reps.py: splits a recording into reps (still-period anchors, drift
    removal per window, zigzag turnarounds, per-rep ROM/MCV/peak, flags)
    - make_fake_reps.py: known-answer test data for reps.py
    - phone_lift.py: reads phyphox xlsx/zip exports, uses total acceleration
    magnitude (tilt-proof), auto-detects the starting still period, reports peak
    - requirements.txt: add openpyxl
    - data: reps_pause.zip, reps_nopause.zip
    - docs: roadmap (0.1 and 0.2 done), algorithm findings, decision D9
    Claude-Session: https://claude.ai/code/session_01NUY9PwUBUqtB2qcc3A6A1w
    [make_fake_reps.py, phone_lift.py, reps.py]
2026-10-16 BOM: XIAO nRF52840 Sense 3-pack instead of single pre-soldered board
    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
2026-10-16 Web app v0 (steps 0.4 + 0.5): live phone reps, replay, CSV export
    - webapp/: phone motion sensor source, recording replay (phyphox csv/zip),
    live rep detection, big last-rep MCV, ROM/peak/velocity loss, height plot,
    rep table, Save CSV in the format the Python scripts read, wake lock
    - webapp/reps.js: line-for-line port of analysis/reps.py
    - webapp/test/parity.mjs: JS vs Python parity test (all files 0.000 mm)
    - analysis/reps.py: --json output for the parity test
    - .nojekyll so GitHub Pages serves files as-is
    - roadmap: 0.4 and 0.5 done
    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
2026-10-16 No-pause sets: level the lockouts to remove curved drift
    With 3+ lockouts between two still periods, fit a cubic velocity drift so
    every lockout lands at the same height (algorithm.md 6b, D10). Reps that
    miss the common height by 2+ cm get an "uneven lockout" flag.
    Also: stills of 1 s or more skip the coasting check, which was throwing
    out the real end-of-set still after long no-pause sets.
    Ported to reps.js, parity 0.000 mm on five files (new fake_reps_drift).
    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
    [make_fake_reps.py, reps.py]
2026-10-16 Coasting check that survives long sets + first web app recording
    The first web app set (6 no-pause reps, 60 Hz) drifted to 78-131 cm reps:
    the end-of-set still was rejected as "coasting" because 16 s of drift
    looked like 0.24 m/s of speed, so the set got no drift fix at all.
    When the last anchor is more than 4 s back, the coasting check now looks
    locally instead of integrating: a coast is entered by speeding up and left
    by slowing down, a real stop is entered and left the same way or from rest.
    Same answer as before on every older recording; the new set comes out
    68.9 +/- 1.6 cm.
    Parity 0.000 mm on six files including the new recording.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
    [bar-2026-10-16-1835.csv]
2026-10-16 Live mid-set: provisional lockout leveling + gray uncorrected tail
    Mid-set, everything since the last still had no drift fix, so the live
    height and rep numbers ran upward until the next pause. Now, from the 2nd
    lockout on, the open stretch gets the same lockout leveling with the end
    velocity fitted too. Simulated live on the recordings, reps shown before
    the next pause went from 24-46 cm off their final value to about 2-3 cm.
    The app draws that provisional stretch gray and dashed and grays the big
    number until you pause. Parity test now also checks every file cut off
    partway (reps.py --until), 24/24 pass. Two new web app recordings.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
    [bar-2026-10-16-1844.csv, bar-2026-10-16-1845.csv]
2026-10-16 Bench J-curve sim + reject still periods that hide a slow grinder
    New demo analysis/demos/bench_jcurve.py runs fake bench sets through the
    real pipeline. A smooth 10 cm J-curve costs the magnitude trick only
    2-4 mm of ROM; sideways shake is what hurts (12.6 mm at 2 m/s^2), and
    orientation tracking only beats magnitude if it's within about 1-2 deg.
    Numbers in algorithm.md section 4.
    The sim also found that a slow, smooth 2.5 s grinder passes the
    stillness test end to end and the rep disappears. New check on every
    still candidate: velocity across it, minus a straight line, can't rise
    and fall more than 4.5 cm/s (real stills 0.2-3, coasts 6-7, grinder 21).
    No real recording changed. Parity 27/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
2026-10-16 Lift picker: level bottoms and the start/end stills where the lift allows
    The app now asks which lift (phone test / squat / bench / deadlift) and the
    drift fix uses every height that repeats: lockouts always; the chest and
    the floor for bench and deadlift; and for barbell lifts the still before
    and after the set, at lockout or floor height. Bottoms are a second group
    in the same least squares, so the drift curve can bend up to tau^5.
    On fake no-pause sets with wobbly drift (10 each, worst-rep ROM error):
    bench 7.0 -> 2.8 cm, deadlift 8.9 -> 4.9 cm (better 10/10), squat
    7.2 -> 6.3 cm (7/10). Phone test unchanged (identical output).
    Lift goes in the saved file name (bar-bench-...csv); reps.p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
    [make_fake_reps.py, reps.py]
2026-10-16 Barbell reps between two lockout stills: same height at both ends
    For squat, bench and deadlift, a window holding one rep between two stills
    at lockout now gets one extra drift bend from "start height = end height"
    (exact fit). Fake paused squats with wobbly drift: worst-rep error
    0.9 -> 0.4 cm and 2.2 -> 0.6 cm, better 10/10. New recording 1920 (5 squats,
    same ROM every rep): spread 3.3 -> 1.7 cm with the squat profile; the 80 cm
    outlier is now 74. Phone test profile output unchanged. Parity 39/39.
    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
    [bar-2026-10-16-1920.csv]
2026-10-17 Android plan (Capacitor wrapper) + CLAUDE.md for Claude Code on the PC
    D12: the Android app wraps webapp/ with Capacitor so it gets full-rate
    phone sensors and native BLE while reps.js and the parity test stay as is.
    docs/android.md has steps A0-A4. CLAUDE.md gives Claude Code the project
    rules (Python is the reference, parity test, sample format, lift profiles,
    no em dashes). node_modules/ ignored.
    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
2026-10-17 A1: Capacitor Android shell around webapp/
    Root package.json + capacitor.config.json (io.github.steveyme19.bartracker,
    webDir webapp), Capacitor 8.5, generated android/ project. Gradle wrapper
    bumped to 9.1.0 so it runs on the PC's Java 25 (D13). Build/install notes
    in docs/android.md. webapp/ and analysis/ unchanged.
2026-10-17 A2: native phone sensors in the Android app (402 Hz)
    BarSensorsPlugin.java reads TYPE_ACCELEROMETER + TYPE_GYROSCOPE at the
    fastest rate (HIGH_SAMPLING_RATE_SENSORS declared), timestamps from
    SensorEvent.timestamp, gyro in deg/s, ~50 ms batches. NativeSensorSource
    in sources.js uses the bridge's Capacitor.Plugins proxy (no bundler).
    app.js picks it in the app, paces live analysis to max(500 ms, 2x last
    pass), and waits for the last batch on Stop. android/pull-recording.mjs
    pulls the last set over adb until A3.
    Measured 402 Hz on the Pixel 9 Pro XL (ICM45631). Parity 39/39 PASS.
    Still to do for A2: a real moving set checked in Python.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
2026-10-17 A2 done: native 402 Hz recording matches Python, added to parity
    bar-phone-2026-10-16-2123.csv: 5-rep phone test recorded in the Android
    app with native sensors, pulled over USB. Python gives the same reps,
    ROM, MCV, peak and flags as the app. Parity 42/42 PASS.
    [bar-phone-2026-10-16-2123.csv]
2026-10-17 Native 402 Hz squat set (A2 comparison), added to parity
    [bar-squat-2026-10-16-2131.csv]
2026-10-17 Browser squat set, V_ZERO roundoff fix (D14), native vs browser write-up
    bar-squat-2026-10-16-2134-browser.csv captured from the Chrome tab over
    USB. It exposed a JS/Python parity failure: v at an anchored window end
    is +/-5.6e-17 with opposite signs, so `v <= 0` ended rep 2 one sample
    apart. find_reps now treats |v| <= 1e-9 m/s as zero in both. Parity
    48/48 PASS.
    docs/android.md: native vs browser table. Native isn't better yet:
    the start-on-box bump and the duration-dependent hump test dominate.
    [bar-squat-2026-10-16-2134-browser.csv]
2026-10-17 Hump limit 4.5 -> 12 cm/s (D15): held squat lockouts are anchors again
    On the native squat set, lockouts held 1-2 s measured 7.5/8.9 cm/s of
    hump (mostly the next descent leaking into the window edge) and were
    rejected. The resulting 9.6 s drift window caused both the uneven
    lockouts and the early starts on the box (MCV 0.31/0.38 -> 0.44/0.61).
    At 12 cm/s only those two stills change across every recording; coasts
    are still caught by the coasting check and the sim grinder (21) by the
    hump. Parity 48/48 PASS.
    [reps.py]
2026-10-17 A3: save/share CSV from the app, keep the screen on during a set
    Save CSV in the app writes Documents/BarTracker/<name>.csv through a new
    BarSensorsPlugin.saveText method and opens the @capacitor/share sheet.
    keepScreenOn sets FLAG_KEEP_SCREEN_ON from Start to Stop. Browser keeps
    its download and Wake Lock. Android extras live in webapp/native.js.
    @capacitor/filesystem dropped: it needs a Java 21 toolchain (D16).
    Verified over USB: file saved (2308 rows), screen flag set during the
    set and cleared after. Share sheet not yet tried on the phone.
    Parity 48/48 PASS.
2026-10-17 A3 done: app-saved set round-trips to Python, added to parity
    [bar-phone-2026-10-16-2206.csv]
2026-10-17 Session mode: sets and rest found automatically, set cards, auto-save
    Start once, lift, walk away (D17). analysis/sets.py splits a workout
    into sets (0.25 s activity blocks, 15 s of quiet ends a set, rack moves
    dropped, rest = first rep minus last rep of the set before); webapp/sets.js
    is a live sample-by-sample port with session parity. reps.py gets an
    analyze() function like reps.js (no behavior change).
    App: one big state card (ready / live set / rest timer), set cards with
    lift fix, weight and your RPE, RPE estimate v0 (D18, uncalibrated),
    vibration on set start/end, Tools drawer for replay (1/10/30x). Each set
    auto-saves to Documents/BarTracker/session-<stamp>/ plus session.csv
    (sets,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
    [make_fake_session.py, reps.py, sets.py]
2026-10-17 Type the exercise and weight; machine profile for weight stacks (D19)
    The lift buttons are replaced by an Exercise box (recent names
    suggested) and a Weight box, both sticky for the next set and editable
    on every set card. The name picks the tracking profile: squat / bench /
    deadlift by name, phone test, anything else a new "machine" profile
    (weight stack: bottoms and ends level, no RPE estimate). Set files end
    in the exercise name; lift_from_name reads the profile from the word
    after "bar-" first. session.csv gets an exercise column.
    The 12 cm rack-move floor now covers machines too: without it a stack
    bump became a fake 1-rep set in testing. Parity 54/54 PASS (machine
    session added).
    Co-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
    [reps.py, sets.py]
2026-10-17 Vintage logbook look: parchment, ink, oxblood/navy, serif, ruled log
    Restyled style.css (same class names, scripts untouched apart from the
    masthead date and the plot's serif labels). Inputs are fill-in lines,
    labels small caps, the big card is framed and turns oxblood in a set and
    navy at rest. Device serif fonts only, so it still works offline.
2026-10-17 Hardware v1 plan: one printed pod, two bar adapters
    hardware/enclosure.md: the pod (LiPo under the XIAO, flat square faces so
    it doubles as the 6-position calibration cube, USB-C slot, 2 x M3 inserts
    as the one adapter interface), a sleeve-end puck with pot magnets (IMU on
    the bar axis) and a V-groove shaft saddle with a strap (IMU ~30-35 mm off
    axis). Print list by phase, what to measure first, extra parts, and the
    user parameters for a parametric Fusion model. Sketch: layout_v1.png.
    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
2026-10-17 Fusion 360 script for the pod v1 (case + lid), parametric
    hardware/enclosure/pod_v1/pod_v1.py builds a new design with every size
    from enclosure.md's CAD table as a user parameter (first guesses) plus
    the extras the model needs: battery pocket loaded through a far-end slot
    under a tray (the LiPo is wider than the XIAO, so top-loading under fixed
    ledges can't work), XIAO ledge + fence, USB-C slot, LED thin spot, reset
    pinhole, 4 M2 lid screws, 2 M3 inserts 20 mm apart under the IMU.
    floor is floor_t (floor() is a Fusion function). Adapters not yet.
    Offline check: all parameter expressions resolve, 16 geometry checks pass
    with the first guesses (40.8 x 25.3 x 22.5 mm). Not yet run in Fusion.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
2026-10-17 Experiment: RTS smoother + adaptive stillness for drift
    analysis/experiments/smoother.py runs a Kalman filter (height, velocity,
    wandering accel bias, lockout and bottom heights) forward through the set
    and back (RTS), with stills as v = 0, lockouts/bottoms as shared heights,
    and, once the last still is 2+ s back, shorter shakier pauses as weak
    v = 0 hints. Fakes with wobbly drift: worst-rep ROM error 2.5-16.5 cm ->
    0.1-0.7 cm. Real phone sets: a tie. Not used by the app; port only if it
    wins on a known-ROM recording (README in the folder).
    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
2026-10-17 Stillness matches the sensor's noise (D20); the gyro picks machine vs free (D21)
    D20: stillness limits are 4x / 5x the rest wiggle in the longest still, so a
    smooth cable lowering no longer counts as still (lat raise on the stack: 3 bogus
    reps -> 8). Reps can start at the usual bottom, which cuts the cable take-up off
    rep 1. Adds the lat raise recording.
    D21: detect_mount() reads the gyro. A stack moves straight without turning
    (0.7 deg/s, sideways 0.20); hand-held recordings turn 10 to 25 deg/s. Squat,
    bench, deadlift and phone by name still win; any other name goes by the sensor,
    with a new "free" profile for free weights it can't name. analyze() now returns
    lift, mount and noise, and set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
    [bar-machine-2026-10-17-1334-set01-lat-raise.csv]
2026-10-17 App: the sensor picks machine vs free weight live and on set cards (D21)
    runLive() and the set-card re-analyze pass imuOf(samples) to analyze()
    and use res.lift (the name if res.error) for dropRackMoves/setSummary.
    The card re-analyze no longer skips when the name maps to the same
    profile: for anything but squat/bench/deadlift/phone the sensor decides.
    Set cards show what was detected (machine / free weight, rot and side
    in the tooltip). Exercise starts blank (blank = sensor decides, "free"
    if it can't tell); a saved "Phone test" starts blank too; "Phone test"
    stays in the suggestions. Hints: machine = the sensor checks, new free.
    Parity 62/62 PASS. Browser: real lat-raise stack file -> mac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
2026-10-17 Velocity-loss alert: buzz and red card when a set passes your target
    A sticky 'Stop at loss' % next to the weight (default 20, 0 = off). Live,
    once a set has 2+ reps and last-rep vs best-rep loss reaches it: one
    long-short-long buzz, the card turns red and says to stop the set. Set
    cards mark the loss in red when a set went over. Roadmap 4.2.
2026-10-17 Remember sessions: IndexedDB history, open past sessions, resume
    webapp/store.js keeps a small record per session (sets without raw data)
    plus each set's samples as typed-array columns. History lists past
    sessions; opening one restores its cards by re-running the pipeline on
    the stored samples (identical numbers in testing), and weight / RPE /
    exercise edits are saved back. A session the app lost (killed, crashed)
    shows a Resume bar at the next start; rest across the gap uses the wall
    clock. Session ids/folders now include seconds: two sessions in the same
    minute overwrote each other. Replays aren't stored.
2026-10-17 Load-velocity profile and e1RM per exercise (D22)
    analysis/lv.py (reference) + webapp/lv.js: best-rep MCV vs weight,
    least squares over the same exercise name (60 days of history + today),
    e1RM where the line reaches the lift's v1RM, squat/bench/deadlift only,
    not past 2x the heaviest weight. Set cards show e1RM and 'usual at this
    weight' vs this set (baseline fitted without it); the rest card shows
    the e1RM. Parity 67/67 (5 new lv cases).
2026-10-17 Screen-off recording: foreground service + wake lock, native buzz
    RecordingService (type health, partial wake lock, 4 h cap, notification)
    starts with a session and stops with it (BarSensors.record). Buzzes go
    through a native vibrate. While the page is hidden, live analysis runs
    from incoming sensor data, since JS timers are frozen. If Android refuses
    the service (app not in front), the session still runs with a message.
    Verified over USB: refused cleanly with the phone locked, service gone
    after End session, vibrate pattern reaches the vibrator. Not yet: a
    real start-lock-lift-unlock test.
2026-10-17 Phone calibration: 6-face accelerometer scale + bias (D23)
    Tools > Sensor calibration: lay the phone on each side, still 2 s each
    (it buzzes per side); per axis scale = (up - down)/2g, bias = (up +
    down)/2, g = 9.80. Live samples are corrected before anything else; each
    session folder gets the calibration.json it used, so raw can be
    recovered. Reference analysis/calib.py, port webapp/calib.js, parity
    69/69; the collector recovers planted errors from a synthetic stream to
    0.01 %. Not yet done on the real phone.
    [calib.py]
2026-10-18 D23: first calibration on the Pixel, errors under 0.15 % (within the fit error)
2026-10-18 pod_v1: skip dimensions Fusion already fixed; first real run builds clean
    Fusion infers a constraint when two hole centres share a coordinate, so
    the second hole's matching dimension over-constrained the sketch and the
    script stopped at the M3 inserts. dim() now skips over-constrained
    dimensions and the final message lists them (3 on this model). Ran in
    Fusion: 40.8 x 25.3 x 22.5 mm, IMU (15.9, 12.7), timeline clean.
2026-10-18 pod_v1: rounded corners, bottom chamfer, softened lid top
    R2 fillets on the vertical corners of case and lid (corner_r), 0.6 mm
    bottom chamfer (bottom_ch; prints floor-down), 0.8 mm lid-top fillet
    (lid_r). Faces stay flat (calibration cube). Built clean in Fusion.
2026-10-18 pod_v1: XIAO and LiPo stand-ins; exploded view image
    Stand-in components (board + USB-C + IMU marker, LiPo cell) from the same
    parameters, for the exploded view and Inspect > Interference. Exploded
    view built in Fusion's Animation workspace; image in hardware/enclosure.
2026-10-18 pod_v1: 2 mm gap over the battery for foam tape and the wires to the pads
    There was 0.4 mm between the cell and the tray: no room for the foam tape
    and no path for the battery wires (out of the cell's far end) to the BAT
    pads under the board. batt_gap = 2 mm gives both; the battery slot is the
    full pocket height. 40.8 x 25.3 x 24.5 mm. Rebuilt in Fusion, Inspect >
    Interference with the stand-ins: none.
2026-10-18 pod_v1: battery door, power switch cradle, lid pocket for the USB-C plug
    Battery door: separate press-fit plug that fills the end slot flush.
    Switch: cradle for an SS12D00-type slide switch at the far end, lever out
    through the end wall into a recess so nothing sticks out of a face.
    USB-C: the plug overmold reached 1 mm above the rim, so the lid now has
    a hidden pocket at the USB end. Offline checks pass; in Fusion it builds
    clean, no interference across 5 parts, batt_l 33->40 rebuilds fine.
2026-10-18 Exploded view redone with the battery door and switch cradle
2026-10-18 pod_v1: lid end wall holds the battery; USB-C relief so plugs reach
    The loose press-fit door is gone: the case's far end is open full height
    and the lid has an end wall that closes it, so the lid screws hold the
    battery in. The switch lever passes a slot in that wall (open at the
    bottom) with the recess on it. USB-C: the 5 mm end wall was too thick for
    most overmolds; a 13 mm relief leaves 1.5 mm of wall at the plug (fits
    13 x 7.4 mm overmolds), continued into the lid. Offline checks pass;
    Fusion builds clean, no interference.
2026-10-18 Exploded view with the lid end wall and battery out the far end
2026-10-18 First XIAO sketch: IMU over USB at 208 Hz, plus a PC logger (D24)
    firmware/imu_serial streams t_us,ax,ay,az,gx,gy,gz (device clock, m/s^2, deg/s)
    at the IMU's own 208 Hz, +-8 g / +-1000 deg/s. analysis/log_serial.py saves it as
    a normal recording and prints rate, gaps, rest wiggle, gyro offset and which axis
    is up. Board package: Seeed nRF52 Boards (non-mbed), closes O4.
    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
2026-10-19 XIAO bring-up: crystal timestamps (D25), axis map, all 3 boards pass (1.1, 1.2)
    imu_serial now stamps each sample from RTC2 on the 32.768 kHz crystal, read the
    moment data-ready shows up. micros() on this core is the 1024 Hz RTOS tick, and
    the IMU's own counter runs 2.8% slow, which would put MCV 2.8% high.
    axis_map.py records one file per face and reports the up axis: +x away from
    USB-C, +y toward the 5V edge, +z out of the chip side (hardware/enclosure.md).
    [bar-xiao-2026-10-18-1950-desk.csv, bar-xiao-2026-10-18-1954-timing.csv, bar-xiao-2026-10-18-2000-desk.csv, bar-xiao-2026-10-18-2002-axis-usb-up.csv, bar-xiao-2026-10-18-2029-axis-usb-down-bad.csv, bar-xiao-2026-10-18-2030-axis-d0d6-up.csv, bar-xiao-2026-10-18-2031-axis-5v-up.csv, bar-xiao-2026-10-18-2031-axis-chip-down.csv]
2026-10-19 live_plot.py: scrolling live graph of the XIAO's accel and gyro
    Last 10 s of ax/ay/az/|a| and gx/gy/gz from imu_serial over USB, read on a
    background thread so redraws don't drop samples. Uses the venv's matplotlib.
2026-10-19 pod_v1: measured XIAO, LiPo and USB-C plug; room for the battery wires
    Calipers 2026-10-19: LiPo PL 602030 30.5 x 19.7 x 7.6, XIAO 21.0 x 17.8 x 1.0
    (USB-C 3.3 above the board, 1.3 past the edge), plug overmold 11.0 x 6.0. IMU
    position is provisional (the part measured may be the mic).
    New batt_wire_l keeps 2.5 mm past the protection board for the wires. The
    narrower case needed boss 5.8, a 12 mm USB relief and an 11.5 x 6.6 slot.
    Pod is now 40.8 x 24.5 x 23.4 mm; offline fit checks all pass. Not yet
    rebuilt in Fusion.
2026-10-19 enclosure.md: pod_v1 rebuilt in Fusion with the measured parts
2026-10-19 Pod print files: Fusion STL export script, orient + check, case and lid STLs
    [pod_case.stl, pod_lid.stl]
2026-10-20 pod_v1: real IMU, reset, LED and battery-pad positions from Seeed's KiCad file
    The part measured as the IMU was the microphone. IMU is 8.89 / 4.32 mm from
    the USB-C / D0-D6 edges, so the adapter M3 inserts move to x 4.3 and 24.3.
    BAT pads sit under the board over the tray window. Fit checks all pass.
2026-10-20 pod_v1: drop the switch cradle, lever slots and tray wire hole
    No switch on hand, and the battery wires reach the BAT pads through the
    window under the board, so the half-covered wire hole had no job. Bosses
    back to 6 mm. Offline fit checks pass.
2026-10-20 pod_v1: centered mount holes, Adapter A magnet puck; export the puck too
    The pod's M3 inserts are centered on the pod; the puck (Ø50 x 10, 3 Ø16
    pot magnets) is centered on the IMU and offsets its screw holes, so the
    IMU still sits on the bar axis. pod_export/stl_orient handle the puck
    (printed pod side down). Offline fit checks pass.
2026-10-20 firmware/pod: device firmware with sleep, wake on motion, low-battery cutoff
    Streams like imu_serial. Sleeps after 10 min still or when laid lid-down for
    3 s; the IMU's wake-up interrupt on P0.11 wakes it. Below 3.30 V on battery it
    sleeps with the IMU off until USB or reset. 100 mA charging, QSPI flash deep
    power-down before System OFF. Board facts from Seeed's wiki and KiCad in
    firmware/README.md. Compiles; not yet tested on hardware.
    [pod.ino]
2026-10-20 pod_v1: countersunk M2 lid screws, 6 mm USB end wall, re-placed puck magnets
    Flat-head screws keep the lid top flat (it's a calibration face). The end wall
    grows 1 mm so the USB-end countersinks clear the lid's rounded edge; the puck
    magnets move for the shifted hole pattern. 44/44 offline checks pass.
2026-10-20 firmware/pod: review fixes, bench-tested sleep and wake (D26)
    A 4-lens review (verified by skeptics) plus bench tests on the XIAO:
    - low-battery sleep released the IMU's I2C pins before cutting its power
    (Wire's internal pull-ups would have fed ~0.3 mA into the dead rail)
    - power-cycle the IMU at boot; IMU fault on battery -> sleep, not a busy loop
    - housekeeping every pass, bounded data-ready wait, IMU restart after 1 s
    - lid-down gesture: orientation-independent stillness, 6 s, off while a PC
    has the port open
    - wake reason from readResetReason() (the core clears RESETREAS first)
    - instant re-wake from System OFF fixed by settling before OFF (4/4 woke
    instantly before, every sleep he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
    [pod.ino]
2026-10-20 BLE step 1: PodLink v1 spec (docs/ble.md), D27, android.md A4, the plan
    docs/ble.md is the one spec the firmware, podlink.py and sources.js will follow:
    GATT table, byte layouts (DATA/STATUS/INFO/CAL), CTRL ops with a cmd_seq that
    DATA echoes, sizing, link settings, session hold and sleep, and the phone's
    decoder contract (epochs, tick unwrap, clock mapping, gaps, pkt_seq, stop).
    Checked twice by review workflows: 3 auditors + skeptics (38 confirmed findings),
    then a coverage check and a fresh-eyes implementer (22 more), all folded in.
    Scale factors and frame arithmetic re-checked against LSM6DS3.cpp and pod.ino.
    docs/ble-plan.md is the 13-step build plan (section 0: audit corrections).
    Co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
2026-10-20 BLE step 2: Python reference decoder (podlink.py) and its test bench
    analysis/podlink.py: PodLink v1 frame codecs and PodStream, the phone decoder from
    docs/ble.md section 7 (epochs, tick unwrap, clock mapping, cmd_seq streams,
    gaps, pkt_seq, stop / finish). Standard library only; reference for the JS port.
    analysis/make_fake_pod.py: a simulated pod (ring, sender, CTRL ops, sleep), a
    simulated link (latency, jams, loss) and 29 scenarios. Each checks, against the
    simulator's truth: per-boot index accounting (samples + counted gaps tile the
    range exactly), values, tick spacing, gap t0/t1, wallBase, zero anomalies,
    exact faults. A replay from the log must reproduce everything; the log is the
    J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
    [make_fake_pod.py, podlink.py]
2026-10-20 BLE step 3: JS PodStream (sources.js) + pod.mjs vector test, bit-exact
    POD, decodeFrame and PodStream in webapp/sources.js, a line-for-line port of
    analysis/podlink.py (no DOM at module top, so Node imports it).
    webapp/test/pod.mjs replays every scenario's logged input (frames, commands,
    STOP, timer calls) and requires the Python output exactly: samples bit for
    bit, gaps, counters, faults, events, command bytes, stop timings.
    31/31 PASS; parity.mjs still all PASS. JS mutation test: 28/30 planted bugs
    fail pod.mjs, the other 2 are equivalent mutants. Three bench scenarios added
    (link degrades then wake, stop-start then link lost, a repeated stop timeout)
    for bugs only the Python-side checks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
    [make_fake_pod.py]
2026-10-23 BLE step 4: ring + frame packer over USB, verified on the board
    - firmware/pod/podlink.h: PodLink v1 constants, UUIDs, DATA/STATUS/INFO packers
    - pod.ino: 8192-sample ring (raw counts + extended RTC2 tick, one rtcExtend()
    for CSV and frames), USB packer behind PKT_OVER_USB (left false), STATUS/INFO,
    IMU restart table, boot_id/wake reason, bench command i (IMU stops sampling)
    - podlink.py --usb [--stall=S]: checks the frames against the CSV one to one;
    dt_stats.py: rate / gaps / jitter per recording
    - Board: 600 s, 126,253 samples matched exactly, 1 RTC2 wrap; --stall=20 shows
    one hole excused by IMU_RESTART. dt std 0.052-0.056 ms with the packer on or
    off = the polling floor (step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
    [bar-xiao-2026-10-23-1609-step4-pkt-on.csv, bar-xiao-2026-10-23-1613-step4-pkt-off.csv]
2026-10-23 BLE step 5: the pod's Bluetooth service, verified from the laptop
    - firmware/pod/ble.ino: PodLink v1 GATT table, advertising (BarPod-XXXX), the
    sender (sd_ble_gatts_hvx, 3 in flight, never blocks), CTRL queue with
    STREAM_FROM / STREAM_LIVE / STOP, STATUS, link-setup timeline, session hold.
    Shaped by an audit of the installed Bluefruit52Lib: connect/disconnect from
    the event callback, no BLEConnection pointers in loop(), sd_* calls direct.
    - D28 (two bench findings): every notification goes out on DATA (Windows
    reordered STATUS vs DATA across characteristics and the decoder saw a fake
    reboot); the sample poll reads the IMU with hardware-sequenced I2C
    (imuRead), because Wire's CP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
    [bar-xiao-2026-10-23-1748-step5-adv.csv, bar-xiao-2026-10-23-1759-step5-stream.csv, bar-xiao-2026-10-23-1814-step5-stream-final.csv]
2026-10-23 BLE step 6: the pod in the browser (Connect pod), tested in real Chrome
    - webapp/sources.js PodWebSource: Web Bluetooth pick / connect (with a retry
    for Chrome's late disconnect), the connection order, STREAM command, start
    with a 10 s timeout, STOP handshake, capture in make_fake_pod.py's format.
    A closed check after every await and a per-device owner, so a connect that
    outlives a failed start can't come back as a second source.
    - webapp/app.js: Connect pod / Use the phone (sticky), the pod branch of
    startSession, footer, t0Wall from wallAt, lastHiddenRun reset, controls
    locked while starting, no empty session stored on a failed start.
    - webapp/test/pod_browser.mjs: real Chrome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
    [bar-deadlift-2026-10-23-1857-set01.csv, pod-capture-2026-10-23-1857.csv]
2026-10-24 BLE step 7: roadmap 1.4 proof, the pod over Bluetooth equals its USB stream
    - analysis/log_ble.py: the receiver (PodStream, reconnect with STREAM_FROM,
    --outage drops, STOP handshake); saves samples, the capture as it happens
    (replayable) and a link JSON (gaps, faults, how it ended, the pod's loss
    counter per boot); never overwrites an earlier run.
    - analysis/compare_ble_usb.py: locks a BLE file onto a simultaneous USB file
    by values and time steps, then requires every sample to match and every
    missing one to be a counted gap at the right place; checks coverage,
    a clean end and the pod's counter. Catches 10 planted faults.
    - 10 min together: 126,888 BLE samples = their USB twins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
    [bar-pod-2026-10-24-1208-smoke7.csv, bar-pod-2026-10-24-1210-proof7.csv, bar-pod-2026-10-24-1221-outage7.csv, bar-pod-2026-10-24-1242-final7.csv, bar-xiao-2026-10-24-1208-smoke7.csv, bar-xiao-2026-10-24-1210-proof7.csv, bar-xiao-2026-10-24-1220-outage7.csv, bar-xiao-2026-10-24-1242-final7.csv]
2026-10-24 BLE step 8: data-ready interrupt sampler and watchdog (D29), verified on the board
    The IMU's pulsed data-ready on INT1 is stamped in the ISR and wakes a priority-4 sampler task
    (sampler.ino) that owns the IMU's I2C and fills the ring; loop() only sends (non-blocking USB
    CSV and # lines, BLE). 8 s watchdog fed from loop(); missed_drdy in STATUS; FW_BUILD 8.
    Final build, 10 min BLE + USB with a 30 s link drop: 210.41 Hz, 0 gaps, dt std 0.0168 ms
    (the poll gave 0.042 to 0.056); all 126,384 BLE samples matched their USB twins, 0 missing,
    the drop lost 0; the pod's missed/late/holes/read-error counters all 0. D26 bench set: w 5/5,
    s + pickup 3/3 (woken by INT1), lid-down, o; i restart hole 1053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
    [bar-pod-2026-10-24-1613-soak8.csv, bar-pod-2026-10-24-1704-soak8final.csv, bar-xiao-2026-10-24-1612-soak8.csv, bar-xiao-2026-10-24-1704-soak8final.csv, pod-capture-2026-10-24-1613-soak8.csv, pod-capture-2026-10-24-1704-soak8final.csv]
2026-10-25 BLE step 9: sleep with a phone connected, verified on the board
    Before any sleep the pod parks the sampler, drains DATA to the final head (at most 1.5 s, FINAL
    on the last frame), sends going_to_sleep with the reason, waits for it to leave and disconnects
    on purpose. New BLE SLEEP op (mode 0 motion wake, 1 IMU off); every goToSleep caller passes its
    sleep_reason; the w dry run runs the phone side too. setup() samples during the 2 s USB wait and
    serves the link there, so a pickup on USB power reaches the phone. FW_BUILD 9.
    log_ble.py --sleep and --until-wake; check_sleep.py turns a sleep + pickup run into PASS lines.
    Bench, all PASS: USB s 3/3 and BLE SLEEP 3/3 (sleep-tail 0, disconnect 129-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
    [bar-pod-2026-10-24-1732-dry9a.csv, bar-pod-2026-10-24-1759-dry9b.csv, bar-pod-2026-10-24-1838-s9usb1.csv, bar-pod-2026-10-24-1839-s9usb2.csv, bar-pod-2026-10-24-1840-s9usb3.csv, bar-pod-2026-10-24-1842-s9ble1.csv, bar-pod-2026-10-24-1843-s9ble2.csv, bar-pod-2026-10-24-1844-s9ble3.csv]
2026-10-25 BLE step 10: the web app reconnects by itself, with epochs and gap flags, verified in Chrome
    PodWebSource reconnects after a dropout with backoff (a hanging connect is cancelled at 10 s),
    same PodStream: STREAM_FROM the next index, or index 0 of a pod that slept or reset (a new
    epoch, t still rising). Banners for link lost / asleep / battery low, the rest timer on the
    pod's wall clock, set-card gap flags (gaps.js), link.json, reconnects and epochs in the footer.
    Bench, hands-free in real Chrome on the real pod (test/pod_reconnect.mjs, usb_clock.py as the
    timing truth): 10 s outage lost 0; 60 s outage one overflow gap of 4960, exactly the pod's own
    lost_overflow rise; a watchdog reset placed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
    [pod-capture-2026-10-24-2158-reconnect10.csv, pod-capture-2026-10-24-2202-reconnect10b.csv]
2026-10-25 BLE step 11: the Android PodLink plugin (built and reviewed, not yet run on the phone)
    PodLinkPlugin.java, a dumb pipe for the app: connect() (Nearby devices once; the saved pod,
    else an 8 s scan), the connection order (services, MTU 247, INFO, STATUS, the DATA CCCD), raw
    frames to JS in ~50 ms batches with their arrival time, write() and reread() queued one at a
    time, disconnect(). A drop reconnects with autoConnect and runs the order again ("ready" with a
    new link number; a command computed for an earlier link is refused). Bluetooth switched off is
    handled (an adapter-state receiver and a 5 s no-frame watchdog: Android can drop the client
    without a callback). Android 13+, not 12+ as planne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
2026-10-25 BLE step 11: verified on the Pixel 9 Pro XL
    android/podlink_check.mjs on the phone, all PASS: Nearby devices asked once; connect()
    resolves with mtu 247, INFO and STATUS first; logcat shows the MTU and the DATA CCCD write;
    13.2 DATA frames/s and 1 STATUS/s; the frames through the app's own PodStream at 210.7
    samples/s with 0 gaps; the pod's sleep-and-reset (w) gives lost, an autoConnect and ready in
    19 s, the new boot streaming.
    The harness's first run failed three checks of its own, now fixed: it counted STREAM_LIVE's
    lead-in in the frame rate, closed the pod's USB port before the pod read the w, and read
    logcat after a debug build's verbose event logs had wrapped the buffer.
    Co-Authored-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
2026-10-26 BLE step 12: the app's pod source, checked hands-free on the Pixel (soak still open)
    PodSource (the link logic both pod sources share) and PodNativeSource (the app's
    source on PodLinkPlugin) in webapp/sources.js, wired into app.js; the pod button
    picks the saved pod or, tapped again, the nearest one. The plugin now says
    "linking" when a reconnect's link is up, so End can wait for "ready" and STOP.
    On the Pixel 9 Pro XL (android/pod_session_check.mjs): 210.6 samples/s with the
    screen off, the pod's sleep and reset while dark, back by itself as a new boot
    in 14.9 s with nothing lost, STOP answered, link.json and pod.json saved, the
    capture replayed bit-exact through podlink.py, two sessions b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
2026-10-26 BLE step 12: the soak's tools, checked on a dry run
    android/soak.mjs drives a long app session in parts (start, status, sleep,
    end), the phone on USB only for each command. usb_clock.py --samples keeps
    every sample of the pod's USB stream per boot, the truth. check_soak.py
    replays the app's capture bit-exact, runs compare_ble_usb.py per epoch,
    checks each woken epoch's placement against the USB clock, lists each outage
    with its backlog and what it lost, and checks the buzzes played with the
    screen off (a buzz log in app.js plus Android's vibration history).
    Dry run with a w reset: every check PASS but "no buzzes" (no sets). Review
    (1 held, 5 refuted): gaps were blamed on outages by their sa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
    [check_soak.py, usb_clock.py]
2026-10-27 Bug hunt on the first-workout path: six fixes (D31)
    A review of session mode, sets, storage and the rep math (3 lenses, each
    finding checked by a skeptic who tried to refute it; 12 held, merged to 8):
    - A weight or exercise typed for the next set while the card already says
    Rest went into the set that just finished (it stays open 15 s), and could
    re-track it with the wrong lift profile. Edits now reach the open set only
    while its reps are in progress.
    - The velocity-loss stop buzz fired on a half-finished provisional rep (35%
    live on a set that ends at 0%). It now counts only reps a still locked in.
    - D31: handling the sensor before a set closes added a huge end rep. On a
    real pod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
    [make_fake_session.py, sets.py]
2026-10-27 D32: rep boundaries walk past a too-short pause's drift (review this one)
    A hold at lockout or on the chest too short to be a still left v a hair
    above 0 (drift), and "first v = 0" ran the rep through the whole pause: on
    the fake session's 0.25 s holds 7 of 20 reps read 5 to 24% low against the
    truth, and the pod set's rep 5 read 0.186 with a 0.43 s hold in it.
    Now the boundary is looked for where v <= 3% of the rep's peak, then walked
    on while v keeps falling: to v = 0 when it gets there (the old boundary,
    so clean reps, sticking dips and lockout stalls are unchanged, no threshold
    bias), or to where the pause's drift floor begins. Bar and stack lifts at
    150 Hz or more; hand-held phone test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
    [reps.py]
2026-10-27 Roadmap 0.3, algorithm side: orientation, bar path and tilt in Python (D33)
    analysis/orientation.py: Madgwick's reference IMU update (D3), the gyro
    bias from the stills, world acceleration, the bar axis from the roll
    gesture (refused when the strongest-turning 2 s isn't one), bar path still
    to still and bar tilt (algorithm.md sections 2, 4, 11, 12).
    analysis/make_fake_motion.py: exact-physics scenarios with truth (a flat
    lift, the bar tilted and spun mid-lift, a table slide, a diagonal, a
    J-curve, tilted then spun: two body axes composed).
    --selftest, all PASS: attitude within 0.17 deg while moving, vertical
    within 2.3 mm, forward within 5.3 mm, tilt within 0.25 deg; noise-free it
    is exact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
    [make_fake_motion.py, orientation.py]
2026-10-27 "Not a set" on a set card
    The bug hunt's last open case for D31: moving the pod to another bar can
    make an anchored phantom set of normal size that no threshold can tell from
    a real single. "Not a set" (in the card's Reps panel, confirmed) takes it
    out of the session and the live tracker (which times the next rest from its
    last set), deletes its stored samples and its CSV, gives the next set its
    rest from the set before (wall time) and rewrites session.csv.
    In the browser: a stored session's set 2 dropped, set 3's rest became 220 s
    (set 1's end to set 3's start), the same after reopening, set 2's samples
    gone from IndexedDB; live, during a replay, the next set's rest came out at
    220.1 s fro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
2026-10-27 Roadmap 5.3: the sticking point, Python first, then JS and the set card (D34)
    analytics.md section 4: on a hard rep the bar speeds up, slows, and speeds
    up again. sticking_point (reps.py) / stickingPoint (reps.js), per rep after
    find_reps: the deepest dip of the 50 ms-averaged velocity with a rise on
    both sides, at least 10% of the rep's peak deep, between 10% and 90% of the
    ROM; where (% of the ROM), the speed there, the depth. The set card shows
    each rep's and the set's median ("Sticks at ~41% of the way up, 3 of 5").
    Known answer: make_fake_reps.py sticking (2 light reps, 3 with a dip):
    found within 0.2% of the ROM, none on the light ones, none on any other
    file. Parity compares it on ev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
2026-10-27 Roadmap 5.2: rep, set and session consistency in Python
    analysis/consistency.py (analytics.md sections 1 and 2): each rep against
    its set's median rep, each set's median against the session's, each set
    against the last 4 earlier sessions of that lift within 10% of the load
    (app exports, D30), on depth (ROM, cm), the velocity profile (v at every 5%
    of height over MCV, RMS) and tempo. Tempo is the eccentric's duration: the
    concentric's is speed, which fatigue is supposed to cut. Stored sets go
    through the closed-set filter first (D31: the unrack, the sensor handled).
    No noise floor yet (roadmap 3.5): every deviation is shown, none judged;
    --floor-* flags those over 2x it. --selftest plants th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
    [consistency.py]
2026-10-27 Night review fixes: nine defects in tonight's own commits
    A review of babbd13..7906036 (3 lenses, a skeptic per finding; 9 held,
    2 refuted), all fixed:
    - D31: the "2x the other reps" scale counted a ~0 m unrack bump, so a heavy
    single read as handling and the set vanished. Rack bumps no longer set it.
    - D31: a closed set with no anchored rep (hands left on the racked bar, so
    the end's quiet wasn't a still) lost every rep and its raw data. With none
    anchored it now keeps them all, flagged.
    - The resume bar's Close wrote back the page-load snapshot: a deleted session
    came back as an undeletable ghost, edits and "Not a set" were undone. It
    re-reads the record now; Delete hides a stal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
    [consistency.py, make_fake_motion.py, orientation.py, sessions.py, sets.py]
2026-10-27 Second review fixes: consistency's tempo, grouping and exports; the sticking known answer (D35)
    A review of f298454 (sticking point) and 001b081 (consistency), a skeptic
    per finding: 8 held, 0 refuted, all fixed.
    consistency.py (D35):
    - eccentric() timed blips, not the lowering: a box sit's bottom wobble
    (real squat 2131: 0.08 s for a 1.46 s descent, tempo +624%) and a
    deadlift's settle at lockout (0.028 s for 3.05 s, -98%). The review's fix,
    the run holding the peak speed, then timed the pod lifted off the stack
    after the lat raise's last rep (faster than its lowering). Now: the run
    nearest the rep that drops at least half its ROM, timed at its own 3%.
    - lift != "deadlift" read e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
    [consistency.py, make_fake_reps.py]
2026-10-27 Roadmap 5.4: RPE v1 in Python, fit on sets to failure, checked on unseen sessions (D36)
    analysis/rpe.py reads app exports (D30, deduped by consistency.py's
    loader). A set with Your RPE 10 (the app has no failure mark yet; a
    toFailure field is read if a set ever has one) labels rep k of N with
    N - k reps in reserve. Per exercise name: RIR = a + b x MCV by least
    squares, reported as v0's two numbers (the MCV at failure, the MCV per rep
    in reserve). Leave one session out, near failure (RIR 0-3) and further;
    the mean residual per load; each normal set's RPE range (+/- the held-out
    error, at least half a point, 5..10) next to your own call.
    --selftest: a synthetic squatter (MCV = 0.25 + 0.045 x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
    [rpe.py]
2026-10-27 Third review and RPE review fixes: which side a lowering is on, split lowerings, the failed attempt (D35, D36)
    Reviews of b4d9e0e (6 findings) and 0682e14 (13), a skeptic per finding,
    0 refuted. All fixed.
    - The side was by name for the big three and by the lead-in alone
    otherwise: a Romanian deadlift (tracked as a deadlift), a pin squat
    (tracked as a squat) and a bent-over row (its hinge from the hang is a
    lead-in) each read every rep against its neighbour's lowering. The two
    suggested fixes contradicted each other (data-only fails the row), so
    lowers_first() reads both ends: a lead-in descent, and a last lowering
    landing at the last rep's start. One witho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
    [consistency.py, make_fake_reps.py, rpe.py, sessions.py]
2026-10-27 Fourth review fixes: tempo per gap between reps; one rule for which reps of a set to failure count (D35, D36)
    A review of a325c95: 14 findings, 1 refuted.
    consistency.py (D35), redesigned rather than patched: four rounds each
    found a lift on which guessing the side of a rep's lowering read every rep
    against its neighbour's (this round: the join swallowing a set-down, a
    cut-off rep read as the last lowering, an RDL set down on the floor, a curl
    from a high rack), and the reviewers showed traces no rule on a set's ends
    can split. Tempo is now per gap: the lowering between two reps, the same
    event whichever side it belongs to; before the first rep and after the
    last aren't used. lowers_first()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
    [consistency.py, rpe.py]
2026-10-27 Fifth review fixes: which reps of a set to failure count, made local; rest-pause; baselines guarded (D35, D36)
    A review of a486179: 9 findings, 1 refuted.
    rpe.py labeled_reps() (D36):
    - A paused set's next rep's pause in the hole read as resting on the
    safeties, so a shallow completed rep ended the set (every label 2-4 low).
    A miss ends a set to failure, so only the last two reps can be one, and
    the stills looked at stop where the bar is back at lockout.
    - "Came to rest low" was against the set's first still; plain heights drift
    window by window (the real squat 2131's lockouts read up to +0.56 m), so a
    miss spliced on read the safeties at -0.07 m for a true -0.67 and was
    counted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
    [consistency.py, rpe.py]
2026-10-27 Sixth review fixes: reracks, nudged rests, a rep's own lowering, floor pickups (D36)
    A review of e946e78: 13 findings (8 distinct), 2 refuted.
    - A miss stuck in the hole (no rep to reps.py), or the bar set down, then
    lifted back into the hooks: the rerack was the RIR-0 rep, or with 6 s+
    on the safeties the only one. A last rep rising from a still in the hole
    2.5 s longer than any pause before is that rerack.
    - A short completed rep followed by a still in the hole (touch and go at
    the top, or set straight onto the safeties) was cut as a miss. A miss
    must now also rise under 0.8 x its own lowering; a short completed rep
    rises back up all of it. That ma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
    [consistency.py, rpe.py]
2026-10-27 Seventh review fixes: one notion of a still for reracks and rests; the unguarded rules pinned (D36)
    A review of f06871e (regressions, crashes, real data, doc accuracy): 4
    findings, 3 refuted.
    - The rerack rule timed single stills while the rest rule joined stills
    split by a bump, so a miss stuck in the hole with the bar bumped on the
    safeties (6.5-8 s, nudged) left only the rerack labeled, as RIR 0 at
    0.352 m/s (true 0.25). Both now go through one stills() helper.
    - The height check of the rest join, the rerack rule's "longer than any
    pause before", SET_DOWN lowered, NEAR either way, the miss window widened
    and JOIN_GAP lowered all survived the self-test. Each now has a case: a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
    [rpe.py]
2026-10-30 Roadmap 1.3: the pod's calibration tool, and an assembly checklist for the parts (D37)
    analysis/calib_pod.py: one guided USB recording (python calib_pod.py COM5,
    the raw CSV kept) or a recording file. 20 s of rest (noise per axis, gyro
    bias), the 6 faces (calib.py's fit: accel bias and scale), then whole turns
    about each axis (gyro scale = the integrated angle / 360 x the turns). A
    turn counts only within 3% of a whole number of turns, under 15% on the
    other axes, with gravity before and after within 2 deg; the spin about the
    vertical goes against a straight edge, since gravity can't see it. Writes
    data/pod-calibration-*.json, corrected = (raw - bias) / scale.
    --selftest: a synthetic pod at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
    [calib_pod.py]
2026-10-30 Calibration review fixes: turns in pieces, each turn's own axis, propped faces; no room for the JST (D37)
    calib_pod.py: a roll done a face at a time chains until gravity is back within 45 deg; a spin
    stopped short and pushed on by under 45 deg is one spin, one turned back over 2 deg is refused;
    the angle is about the turn's own axis, not its share on the board's; each face's flattest
    still, a 0.05 m/s^2 residual check and a redo prompt; the rest reading anchored on the slowest
    quiet block (a steady turn longer than the stills had become the rest); live: refused turns and
    the USB-C-end hint printed as they happen, OSError handled. Self-test: 18 checks incl. the
    hand's cases, a drifting bias,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
    [pod_case.stl, pod_lid.stl, puck_a.stl]
2026-10-31 The battery is soldered to the pads: what that changes, and how to do it (D38)
    The 10-21 print has no room for a mated JST-PH pair, so the cell's leads go
    straight to the XIAO's BAT pads: no connector, no switch, no hard off.
    - D38: off is the deep sleep, the IMU-off sleep is for storage, and the reset
    pinhole replaces "unplug" as the recovery (a pin reset clears the watchdog,
    per Nordic's reset table). Amends D26: the 3.30 V cutoff only runs awake,
    so a soldered pod asleep at the cutoff still drains. The gaps the unplug used
    to cover are listed as not guarded yet (the cutoff while asleep, the
    IMU-not-found loop on USB, imu_serial).
    - enclosure.md: the decision recorded, stale JST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
    [pod.ino]
2026-10-31 Gym prep: keep a dropped segment's raw samples (D39), the gym-day checklist, today's recordings
    - sets.js hands a dropped segment's samples to onDrop; app.js saves them as
    drop-<lift>-<stamp>-<hhmmss>.csv whenever it autosaves (P2). parity.mjs checks
    every drop is non-empty, in order and clear of the sets, and that the fake
    squat session drops exactly its no-rep rack walk.
    - docs/gym-day.md: what to do before and at the first loaded-bar session, from
    a readiness audit (four auditors, each with a skeptic).
    - analysis/data: the assembled pod's first USB check (210.4 Hz, 0 gaps,
    3.99 V charging) and the phone's sessions pulled before the reinstall
    (the 10-25 soak's stub and four 10-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
    [bar-deadlift-2026-10-31-1210-set01.csv, bar-xiao-2026-10-31-1248-assembled-check.csv, session.csv]
2026-10-31 The phone check's sessions and the first set the new app saved from the pod (10-31)
    [bar-deadlift-2026-10-31-1344-set01.csv, session.csv]
2026-10-31 The first gym session with the assembled pod (2026-10-31): five sets, raw
    Squats 135, 225, 360 x 3 (2 RIR), paused deadlifts at 150, machine ham
    curls at 180, one app session per set (P2). The app counted 3, 1, 1 and 1
    reps on the barbell sets (truth from video: 8, 6, 3; the deadlift 5) and
    the ham curl's 10 right. The squat videos stay on disk next to their
    sessions (analysis/data/**/video/ is gitignored).
    [bar-deadlift-2026-10-31-1428-set01.csv, bar-machine-2026-10-31-1447-set01-ham-curl.csv, bar-squat-2026-10-31-1408-set01.csv, bar-squat-2026-10-31-1410-set01.csv, bar-squat-2026-10-31-1413-set01.csv, session.csv]
2026-10-31 Real-bar reps: anchor on turnarounds, track the true vertical (D40)
    A loaded bar never stops between reps (a squatter's 2.7 Hz sway, 20 ms
    touch-and-go tops, plates ringing at 20 Hz on the floor), so the still-
    anchored pipeline saw one window from unrack to rerack and miscounted every
    barbell set of the first gym session: 3/8, 1/6, 1/3 squats, 1/5 deadlifts.
    - Bar lifts with a gyro at the pod's rate use the acceleration along up:
    Madgwick (moved into reps.py; orientation.py imports it back) pulled onto
    gravity at stills and quasi-stills, its pull floored (SN_FLOOR) so it isn't
    chaotic in roundoff.
    - A window that's broken or holds a gyro-confirmed impact is redone rep by
    rep: a hig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
    [make_fake_motion.py, orientation.py, reps.py]
2026-11-01 Battery guards for the soldered cell (D38): cutoff at boot, IMU-not-found, imu_serial
    The gaps the JST unplug used to cover, now that the LiPo is soldered to the pads:
    - pod: the 3.30 V cutoff runs at every boot (3 readings 20 ms apart) before the radio,
    the sampler or the lid-down gesture can run, so a pod woken near empty or reset while
    flat blinks red x3 and takes the IMU-off sleep instead of sleeping again unchecked.
    - pod: setup()'s IMU-not-found loop rechecks USB every pass and sleeps IMU-off once it goes.
    - pod: a low-battery or IMU-lost sleep resets instead of sleeping if USB came in during
    its ~0.7 s setup (VBUS wakes System OFF only on its rising edge; found in review).
    - imu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
    [imu_serial.ino, pod.ino]
2026-11-01 The pod lid-down at rest over USB, and its calibration estimate from every still (10-31)
    - bar-xiao-2026-10-31-2249-lid-down-rest.csv: 60 s, 12628 samples, no gaps; |a| 9.547 m/s^2 with z
    vertical, gyro offset (+0.71, -3.34, +2.20) deg/s.
    - pod-calib-estimate-2026-10-31.json: an estimate, not a calib_pod.py run (D42): accel x -0.179 m/s^2
    +0.46%, y -0.041 +0.45%, z about +0.20 -0.5% (not pinned), gyro z scale +1.0%. Named so that
    calib_pod.py --install's newest-file pick never takes it.
    [bar-xiao-2026-10-31-2249-lid-down-rest.csv]
2026-11-01 Deadlift floor fixes (D41) and the pod's calibration in the app (D42)
    D41, the 10-31 paused deadlift's rep 1 (+31% -> -0.7%, ROM 40 -> 53 cm):
    - A floor pause may end up to TA_FLOOR_REACH (1.0 s) before its coarse low: with no set-down jolt
    before rep 1 the high-pass puts the low at the 6 cm hitch, 0.59 s after the floor rest.
    - Open windows (no end still yet): a floor lift's last rest anchors on all of it, and a turnaround the
    high-pass confirms only in the last TA_SIGMA waits, except the floor the bar has landed on after the
    last rep. Live dips 3 -> 0; a set ended 1.4 s after its last set-down keeps its 5 reps.
    - Review (9 agents + a 6-variant scoring on 36 synthetic floor sets) foun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
    [calib_pod.py, make_fake_motion.py, reps.py, sessions.py]
2026-11-01 D38 bench-checked on the pod, z re-estimated with the puck on, bench protocol from synthetics (11-01)
    - D38 flashed and bench-checked (firmware/README.md): imu_serial switches off without USB,
    the IMU-not-found loop sleeps once USB goes, the boot cutoff blinks red and sleeps without
    advertising, USB wakes the IMU-off sleep with the cell on. Not done: the reset-pinhole step
    (the puck blocks it). Found: unplugging a sleeping pod wakes it (likely the handover tripping
    the IMU's wake-on-motion); an awake pod runs on.
    - Three faces with the Adapter A puck on (lid up, lid down, USB-C up, kept raw) and a new
    estimate: z bias +0.281 / scale +0.31% (D42); x and y kept. z is the bar axis on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
    [bar-xiao-2026-11-01-1106-lid-up-rest.csv, bar-xiao-2026-11-01-1108-flips-lid-down-usb-up.csv, bar-xiao-2026-11-01-1118-lid-down-then-usb-up.csv]
2026-11-02 Paused and racked bench on synthetics (D43)
    reps.py first, reps.js line for line:
    - the bench's coarse pass high-passes at 1.75 s (TA_SIGMA_LIFT)
    - squat, bench and free blank, stop on and rack on impacts only (a chest
    bounce is the bar's own motion); the floor still lands on every jolt
    - a racked set's coarse turnarounds end at the rack (the rack cut)
    - TA_HOLD_V 0.03 m/s at lockouts: a must between reps, and before the
    first rep or after the last it waives the height check
    - TA_START_DROP: a lockout whose coarse height falls 5 mm had the descent
    begin in it (between reps its first 0.5 s, the first hold the 0.5 s up
    to its top)
    - TA_HOOK_MOVE: a move off the hooks under 15 cm isn't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
2026-11-02 11-02 gym deadlifts: two sets on the pod (P2)
    Set 1 (11:06, 389 lb): the app logged 3 reps, 0.28 / 0.24 / 0.22 m/s.
    Set 2 (11:09 session): three full reps on video, but the app logged no set,
    only two drop- files. Kept raw for the fix: each rep sits in its own window
    between floor stills, the slow pulls (about 2 s) shrink below TA_MIN_MOVE in
    the coarse pass, and the window closes with no anchor after the rep. The
    trimmed videos sit beside them in video/ (gitignored).
    [bar-deadlift-2026-11-02-1106-set01.csv, drop-deadlift-2026-11-02-1109-110949.csv, drop-deadlift-2026-11-02-1109-111239.csv, session.csv]
2026-11-03 Below 3.50 V on battery every sleep is IMU-off (D38, Quentin's call)
    goToSleep() drops motion wake when the pod is on battery and lastBattV is under
    LOW_BATT_WARN_V: the same test as STATUS batt_low, so idle, lid-down and the phone's
    SLEEP mode 0 all take the ~7 uA sleep near empty (red x3 instead of blue), about twice
    as long to the protection board's trip, at the cost of the bump wake. The plug-in
    recheck before System OFF now covers every sleep that began on battery.
    The app reads batt_low from the going_to_sleep STATUS: its asleep banner says a bump
    won't wake the pod (plug in USB), the awake battery-low banner says so in advance, and
    the connect errors (JS and PodLinkPlugin) say to plu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
    [pod.ino]
2026-11-04 CRP for the pod link, S1-S5: codec, simulator, JS, C glue, per-link firmware (D45)
    S1 analysis/crp.py: CRP 0x0B packets (checked against crp_packet.c and
    CRPClient byte for byte), level 1 framing with a resyncing deframer, an
    asyncio session with CRPClient's txn ids and no retries, serial and bleak
    links. --selftest 75/75, --vectors.
    S2 podlink.py crp_frame() and PodStream.packet(), pkt rows in replay_rows and
    check_soak; make_fake_pod.py models the engine (HELLO, PUSH, the 4-packet
    spool, push admission, the NOP, BUSY reads, reads built on arrival, USB text
    and CRP modes): 51 scenarios, the 36 old ones (MTU-73 ones at 79) plus 15 CRP
    ones, two of them negative controls; each rule has a mut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
2026-11-04 CRP for the pod link, S6-S9: the pod, the tools and the app speak CRP (D45)
    Firmware (S6, S7): Bluetooth is CRP over service 0x5090 (RX 0x50b0, TX 0x50b1,
    setMaxLen 244) from a static random address of its own (BarPod-XXXX follows
    it); pushes through podcrp with the pass order of docs/ble.md 5; the MTU
    exchange at connect + 50 ms; liveness ignored. USB stays the text CSV until a
    level 1 HELLO switches it to CRP (usb.ino: its own stream, LOG for the #
    lines, the BENCH register, back to text after BYE, END, 3 s silent or a
    closed port, the bench characters guarded after). CTRL answers OK /
    INVALID_VALUE / BUSY; only Bluetooth touches the session hold; boot_id drawn
    even if Bluetooth fails; FW_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
    [ble.ino, ble_check.py, compare_ble_usb.py, link.ino, log_ble.py, log_ble_sim.py]
2026-11-04 D45 on the pod: first bench runs over USB CRP and Bluetooth CRP (P2)
    Flashed 87de3e4 with flash.py. USB text mode unchanged (CSV 210.42 Hz).
    USB CRP (log_ble.py --usb, 60 s): 13,242 samples, 0 gaps, 0 faults, STOP
    answered, LOG lines, back to text after the BYE. ble_check.py all PASS on
    the first run: BarPod-3027 at a static random address (no Bluetooth toggle),
    GATT 5090 RX/TX only, HELLO BPOD, every register answer, discovery names,
    PUSH gating, RESPONSE > STATUS > RESYNC order, 210.41 Hz, lossless resume,
    STOP head. Bluetooth with outages of 3, 10 and 30 s against a simultaneous
    USB text log: 54,832 of 54,832 samples matched (compare_ble_usb PASS, 0
    missing). The 60 s outage didn't run: t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
    [bar-pod-2026-11-04-1433-s6usbcrp.csv, bar-pod-2026-11-04-1436-s7outage.csv, bar-xiao-2026-11-04-1436-s7truth.csv, pod-capture-2026-11-04-1433-s6usbcrp.csv, pod-capture-2026-11-04-1436-s7outage.csv]
2026-11-07 D45 bench, part 2: overflow, dry-run sleeps, Chrome, both links at once (P2)
    On the CRP pod (fw 10):
    - 60 s Bluetooth outage against the USB text truth: compare_ble_usb with the
    link JSON PASS, 36,473 of 36,473 matched, the 5,327 missing one counted
    overflow gap = the pod's lost_overflow rise.
    - Dry-run sleeps (w): Bluetooth x2 check_sleep PASS (disconnect 90 / 134 ms
    after going_to_sleep, sleep-tail 0, a new boot); USB CRP through the new
    log_ble.py --bench=w@T PASS.
    - Chrome: pod_browser PASS (210 Hz, 16/pkt, MTU 247 from the register, End
    handshake, replay 0 diff, two sessions); pod_reconnect --hands-free PASS
    (10 s outage no gap, 60 s overflow 4,936 = the pod's rise, reset pl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
    [bar-pod-2026-11-07-1459-s7overflow.csv, bar-pod-2026-11-07-1503-s9w1.csv, bar-pod-2026-11-07-1506-s9usbw1.csv, bar-pod-2026-11-07-1508-s9w2.csv, bar-pod-2026-11-07-1513-s7exactble.csv, bar-pod-2026-11-07-1514-s6exactusb.csv, bar-xiao-2026-11-07-1459-s7overflowtruth.csv, pod-capture-2026-11-07-1459-s7overflow.csv]
2026-11-07 Name connected Bluetooth audio when a scan finds no pod (D28's trap, again)
    11-07 the soundcore headphones reconnected by themselves and starved the
    laptop's Bluetooth scanning: the pod advertised (its own # ble line said so)
    while log_ble found no BarPod. crp.bt_audio_connected() lists present audio
    endpoints named after a paired Bluetooth device (Windows), and log_ble.py and
    ble_check.py add them to their "no BarPod found" message. D45's status lists
    the 11-07 bench results and what's left (the SLEEP op with a pickup, the
    Pixel end to end, a soak).
2026-11-07 USB soak (26 min, 0 gaps) and a write timeout for SerialLink (D45)
    The soak ended when the pod was unplugged, and that showed log_ble's USB link
    writing with no timeout: the heartbeat's write to the vanished port held the
    event loop for 97 s. SerialLink now opens with write_timeout=1.0 and treats a
    failed write as the link going down, reported once. crp.py --selftest gains
    checks for both, each failing on its planted fault.
    Recording s10usbsoak committed and pinned (P2; the manifest only grows).
    [bar-pod-2026-11-07-1543-s10usbsoak.csv, pod-capture-2026-11-07-1543-s10usbsoak.csv]
2026-11-08 D45 bench, part 4: the Pixel, real sleeps, a Bluetooth soak, and the link-hang audit's fixes
    On the pod and the Pixel (11-07):
    - podlink_check --install --drop and pod_session_check PASS end to end;
    - the real SLEEP op x5 over Bluetooth: the link side passes all 5; the
    pickup-in-the-stream check passes 3 of 5 (a knock shorter than the boot,
    and a gentle lift that didn't trip D26's wake-on-motion);
    - a 40.7 min Bluetooth soak, 512,990 samples, 0 gaps, ending in a real idle
    sleep with the session held (disconnect 136 ms after going_to_sleep).
    A read-only audit (each finding checked by a skeptic) found three more
    faults like the SerialLink write timeout, all fixed:
    - crp.Session: a link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
    [bar-pod-2026-11-07-2123-s7sleep1.csv, bar-pod-2026-11-07-2124-s7sleep2.csv, bar-pod-2026-11-07-2125-s7sleep3.csv, bar-pod-2026-11-07-2126-s7sleep4.csv, bar-pod-2026-11-07-2129-s7sleep5.csv, bar-pod-2026-11-07-2131-s10soak.csv, bar-pod-2026-11-07-2248-s10blesoak.csv, bar-xiao-2026-11-07-2131-s10soaktruth.csv]
2026-11-11 Link stack cleanup, Python: dead code out, one path where there were two, guards that can't pass falsely
    No hardware in this pass; the simulator's six vector files are byte-identical.
    Removed or folded:
    - podlink.py: the PodLink v1 USB check (170 lines for a firmware mode D45
    deleted) and the v1 GATT UUIDs;
    - crp.py: one send path and one shared wait in Session, dead members gone,
    the selftest regrouped (81 checks);
    - log_ble.py: one BUSY retry (shared with ble_check.py), one helper and one
    queue for the bench writes, lost_link set in one place;
    - make_fake_pod.py and log_ble_sim.py: dead parameters and state, repeated
    boilerplate.
    Guards that could pass falsely:
    - a crashing make_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
    [ble_check.py, check_soak.py, compare_ble_usb.py, crp.py, log_ble.py, log_ble_sim.py, log_serial.py, make_fake_pod.py]
2026-11-11 Phone harnesses: fail on a closed DevTools socket, soak end can be run again
    - webview.mjs: once the app's DevTools socket closed, every call stayed
    pending and the harness ended with exit code 0 and no verdict. Now each
    call fails, open or still to come.
    - soak.mjs end: what the soak proves (pid, the foreground service, the
    status) is read before End and kept in the state file, so a second end
    after a failed pull saves what the first one left.
    - PodLinkPlugin.java, RecordingService.java: comments, and NAME_PREFIX
    where the literal was. The plugin's logic is unchanged: its
    simplifications wait for a session with the phone attached.
    Not run on the phone: none was attached.
    Co-Au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
2026-11-11 Docs in line with the CRP link, firmware comments, the cleanup pass in D45
    - docs/android.md, docs/ble.md, both READMEs and CLAUDE.md still described
    the PodLink v1 plugin and firmware in places (reread(), CTRL writes, the
    DATA characteristic, "CRP lands in stages").
    - firmware/pod: comments only (the spool on USB, a stub's reason); the
    compiled image is unchanged. The host test's helpers deduped, its output
    identical, and build.sh no longer skips crp.py's vectors silently.
    - decisions.md D45: what the pass removed, the guards it fixed, what it
    left out because it needs hardware, and what to run first on the bench.
    - CLAUDE.md rule 1: usb_clock.py --selftest, and the manifest rule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
    [link.ino, podcrp.c, podcrp.h]
